angleto/phycommander/docs/INDEX.md

# PhyCMD Documentation Index

Complete guide to PhyCMD documentation.

## Quick Navigation

### 🚀 Getting Started
1. Start here: [README.md](../README.md)
2. Quick setup: [QUICK_REFERENCE.md](getting-started/QUICK_REFERENCE.md)
3. Full user guide: [USER_MANUAL.md](user-guide/USER_MANUAL.md)

### 📖 By Role

#### End Users
- **Start**: [USER_MANUAL.md](user-guide/USER_MANUAL.md)
- **Quick Reference**: [QUICK_REFERENCE.md](getting-started/QUICK_REFERENCE.md)
- **Setup**: [SETUP.md](getting-started/SETUP.md)

#### Developers
- **API Reference**: [API_REFERENCE.md](technical/API_REFERENCE.md)
- **Architecture**: [ARCHITECTURE.md](technical/ARCHITECTURE.md)
- **Protocol**: [PROTOCOL.md](technical/PROTOCOL.md)
- **Building**: [BUILDING.md](getting-started/BUILDING.md)

#### DevOps/System Administrators
- **Deployment**: [DEPLOYMENT.md](deployment/DEPLOYMENT.md)
- **Configuration**: [CONFIGURATION.md](user-guide/CONFIGURATION.md)
- **Performance**: [PERFORMANCE.md](technical/PERFORMANCE.md)
- **Real-Time OS Setup**: [REALTIME_OS_CONFIG.md](deployment/REALTIME_OS_CONFIG.md)

#### Hardware/Firmware Engineers
- **Firmware Upload**: [FIRMWARE_UPLOAD.md](firmware/FIRMWARE_UPLOAD.md)
- **Firmware Updates**: [FIRMWARE_UPDATES.md](firmware/FIRMWARE_UPDATES.md)
- **Wire Protocol**: [firmware/PROTOCOL.md](firmware/PROTOCOL.md) — byte-level spec, v1 + v2 reactive + v3 PID
- **Function Generator User Guide**: [user-guide/FUNCTION_GENERATOR.md](user-guide/FUNCTION_GENERATOR.md) — shapes, LUT, threshold, pulse, PID with examples
- **Device Pinout** (front + rear panel): [DEVICE_PINOUT.md](technical/DEVICE_PINOUT.md)
- **I/O Backplane PCB (Arduino Due shield)** — **design sketch, not fabricated**: [PCB_BACKPLANE_PINOUT.md](technical/PCB_BACKPLANE_PINOUT.md) · see README → Contributions wanted
- **Companion board** (Arduino Due shield + panel): [../companion_board/](../companion_board/)
  - PCB CAD project (KiCad 8 skeleton, **unfabricated**): [../companion_board/pcb/README.md](../companion_board/pcb/README.md)
  - Panel sketches (SVG masters; front+rear are realised on the reference build, PCB backplane layers are the not-yet-built companion shield): [../companion_board/panel_sketch/](../companion_board/panel_sketch/)

---

## Documentation by Category

### Core Documentation

| Document | Description | Length |
|---|---|---|
| [README.md](../README.md) | Main entry point and overview | 10 pages |
| [USER_MANUAL.md](user-guide/USER_MANUAL.md) | Complete user guide | 60 pages |
| [QUICK_REFERENCE.md](getting-started/QUICK_REFERENCE.md) | One-page cheat sheet | 3 pages |
| [API_REFERENCE.md](technical/API_REFERENCE.md) | Complete API documentation | 40 pages |

### Setup & Configuration

| Document | Description | Length |
|---|---|---|
| [SETUP.md](getting-started/SETUP.md) | Initial setup and installation | 15 pages |
| [BUILDING.md](getting-started/BUILDING.md) | Build instructions | 20 pages |
| [CONFIGURATION.md](user-guide/CONFIGURATION.md) | Configuration guide | 30 pages |
| [DEPLOYMENT.md](deployment/DEPLOYMENT.md) | Production deployment | 35 pages |
| [REALTIME_OS_CONFIG.md](deployment/REALTIME_OS_CONFIG.md) | Real-time Linux OS configuration | 45 pages |

### Technical Reference

| Document | Description | Length |
|---|---|---|
| [ARCHITECTURE.md](technical/ARCHITECTURE.md) | System design and architecture | 25 pages |
| [PROTOCOL.md](technical/PROTOCOL.md) | PhyCMD-64 protocol specification | 20 pages |
| [PERFORMANCE.md](technical/PERFORMANCE.md) | Performance benchmarks and tuning | 15 pages |
| [DEVICE_PINOUT.md](technical/DEVICE_PINOUT.md) | Front + rear panel pinout reference (all connectors) | 12 pages |
| [PCB_BACKPLANE_PINOUT.md](technical/PCB_BACKPLANE_PINOUT.md) | I/O distribution PCB pinout, BOM, routing | 18 pages |
| [FIRMWARE_UPLOAD.md](firmware/FIRMWARE_UPLOAD.md) | Firmware upload guide (BOSSA) | 15 pages |
| [FIRMWARE_UPDATES.md](firmware/FIRMWARE_UPDATES.md) | Required firmware changes | 10 pages |

**Total**: ~200+ pages of documentation

---

## Documentation by Task

### Installation & Setup

1. [SETUP.md](getting-started/SETUP.md) - Initial setup
2. [BUILDING.md](getting-started/BUILDING.md) - Build from source
3. [FIRMWARE_UPLOAD.md](firmware/FIRMWARE_UPLOAD.md) - Upload firmware
4. [REALTIME_OS_CONFIG.md](deployment/REALTIME_OS_CONFIG.md) - Configure RT OS (optional)
5. [DEPLOYMENT.md](deployment/DEPLOYMENT.md) - Production deployment

### Configuration

1. [CONFIGURATION.md](user-guide/CONFIGURATION.md) - Complete configuration reference
2. [QUICK_REFERENCE.md](getting-started/QUICK_REFERENCE.md) - Quick config examples
3. [DEPLOYMENT.md](deployment/DEPLOYMENT.md) - Production config

### Using PhyServer

1. [USER_MANUAL.md](user-guide/USER_MANUAL.md) - Complete usage guide
2. [QUICK_REFERENCE.md](getting-started/QUICK_REFERENCE.md) - Common operations
3. [API_REFERENCE.md](technical/API_REFERENCE.md) - API details

### Development

1. [API_REFERENCE.md](technical/API_REFERENCE.md) - API reference
2. [ARCHITECTURE.md](technical/ARCHITECTURE.md) - System design
3. [PROTOCOL.md](technical/PROTOCOL.md) - Protocol specification
4. [BUILDING.md](getting-started/BUILDING.md) - Build instructions

### Performance Tuning

1. [REALTIME_OS_CONFIG.md](deployment/REALTIME_OS_CONFIG.md) - Real-time OS setup
2. [PERFORMANCE.md](technical/PERFORMANCE.md) - Benchmarks and tuning
3. [CONFIGURATION.md](user-guide/CONFIGURATION.md) - RT configuration
4. [DEPLOYMENT.md](deployment/DEPLOYMENT.md) - Production optimization
5. [USER_MANUAL.md](user-guide/USER_MANUAL.md) - Real-time operation section

### Troubleshooting

1. [USER_MANUAL.md](user-guide/USER_MANUAL.md) - Troubleshooting section
2. [QUICK_REFERENCE.md](getting-started/QUICK_REFERENCE.md) - Quick fixes
3. [DEPLOYMENT.md](deployment/DEPLOYMENT.md) - Production troubleshooting
4. [SETUP.md](getting-started/SETUP.md) - Setup issues

---

## Documentation Features

### Code Examples

All documentation includes working code examples in:
- **Bash/cURL**: Command-line operations
- **Python**: REST API and automation
- **JavaScript**: Web interface and WebSocket
- **Rust**: IPC and native integration

### Practical Scenarios

- Development setup
- Production deployment
- High-performance configuration
- Multi-instance deployment
- Remote access setup
- Security hardening

### Complete Coverage

- ✅ Installation procedures
- ✅ Configuration options
- ✅ API endpoints
- ✅ Command-line tools
- ✅ Web interface
- ✅ IPC interface
- ✅ Troubleshooting
- ✅ Performance tuning
- ✅ Security
- ✅ Monitoring
- ✅ Backup/recovery

---

## Search Guide

### By Keyword

**Transport/Communication**:
- USB Bulk transport → [PERFORMANCE.md](technical/PERFORMANCE.md), [USER_MANUAL.md](user-guide/USER_MANUAL.md)
- Serial transport → [CONFIGURATION.md](user-guide/CONFIGURATION.md), [USER_MANUAL.md](user-guide/USER_MANUAL.md)
- Protocol → [PROTOCOL.md](technical/PROTOCOL.md), [ARCHITECTURE.md](technical/ARCHITECTURE.md)

**APIs**:
- REST API → [API_REFERENCE.md](technical/API_REFERENCE.md), [USER_MANUAL.md](user-guide/USER_MANUAL.md)
- WebSocket → [API_REFERENCE.md](technical/API_REFERENCE.md)
- IPC → [API_REFERENCE.md](technical/API_REFERENCE.md), [USER_MANUAL.md](user-guide/USER_MANUAL.md)

**Configuration**:
- TOML config → [CONFIGURATION.md](user-guide/CONFIGURATION.md)
- Command-line → [QUICK_REFERENCE.md](getting-started/QUICK_REFERENCE.md), [CONFIGURATION.md](user-guide/CONFIGURATION.md)
- Real-time → [REALTIME_OS_CONFIG.md](deployment/REALTIME_OS_CONFIG.md), [CONFIGURATION.md](user-guide/CONFIGURATION.md), [USER_MANUAL.md](user-guide/USER_MANUAL.md)
- RT kernel → [REALTIME_OS_CONFIG.md](deployment/REALTIME_OS_CONFIG.md)

**Deployment**:
- Systemd → [DEPLOYMENT.md](deployment/DEPLOYMENT.md)
- Security → [DEPLOYMENT.md](deployment/DEPLOYMENT.md)
- Monitoring → [DEPLOYMENT.md](deployment/DEPLOYMENT.md)

**Hardware**:
- Arduino Due → [README.md](../README.md), [FIRMWARE_UPLOAD.md](firmware/FIRMWARE_UPLOAD.md)
- Pin mapping → [USER_MANUAL.md](user-guide/USER_MANUAL.md), [PROTOCOL.md](technical/PROTOCOL.md), [DEVICE_PINOUT.md](technical/DEVICE_PINOUT.md)
- Front / rear panel connectors → [DEVICE_PINOUT.md](technical/DEVICE_PINOUT.md)
- I/O distribution PCB → [PCB_BACKPLANE_PINOUT.md](technical/PCB_BACKPLANE_PINOUT.md)
- SWD/JTAG debug port → [DEVICE_PINOUT.md](technical/DEVICE_PINOUT.md) §2.3
- CAN bus → [DEVICE_PINOUT.md](technical/DEVICE_PINOUT.md) §2.4
- Firmware → [FIRMWARE_UPLOAD.md](firmware/FIRMWARE_UPLOAD.md), [FIRMWARE_UPDATES.md](firmware/FIRMWARE_UPDATES.md)

---

## Documentation Structure

```
PhyCMD/
│
├── README.md                          # Start here
├── CONTRIBUTING.md                    # Contribution guidelines
├── CHANGELOG.md                       # Version history
├── LICENSE                            # AGPL-3.0 (server) + GPL-3.0 (firmware) + CERN-OHL-S v2 (hardware) + CC-BY-SA 4.0 (docs)
├── TRADEMARKS.md                      # Policy on "PhyCommander" name + logo
│
└── docs/
    ├── INDEX.md                       # This file
    │
    ├── getting-started/
    │   ├── SETUP.md                   # Initial setup
    │   ├── BUILDING.md                # Build instructions
    │   └── QUICK_REFERENCE.md         # Quick reference
    │
    ├── user-guide/
    │   ├── USER_MANUAL.md             # Complete user guide
    │   └── CONFIGURATION.md           # Configuration reference
    │
    ├── technical/
    │   ├── ARCHITECTURE.md            # System architecture
    │   ├── PROTOCOL.md                # Protocol specification
    │   ├── API_REFERENCE.md           # API documentation
    │   └── PERFORMANCE.md             # Performance guide
    │
    ├── deployment/
    │   ├── DEPLOYMENT.md              # Production deployment
    │   ├── REALTIME_OS_CONFIG.md      # Real-time OS configuration
    │   └── REMOTE_ACCESS.md           # Remote access guide
    │
    ├── firmware/
    │   ├── FIRMWARE_UPLOAD.md         # Firmware upload (BOSSA)
    │   └── FIRMWARE_UPDATES.md        # Firmware updates
    │
    └── reports/
        ├── PRODUCTION_READINESS_REPORT.md
        ├── PRODUCTION_READINESS_REPORT_FINAL.md
        └── PRODUCTION_READINESS_VERIFICATION.md
```

---

## Recommended Reading Order

### For New Users

1. [README.md](../README.md) - Overview
2. [SETUP.md](getting-started/SETUP.md) - Get it running
3. [USER_MANUAL.md](user-guide/USER_MANUAL.md) - Learn to use it
4. [QUICK_REFERENCE.md](getting-started/QUICK_REFERENCE.md) - Keep handy

### For Developers

1. [README.md](../README.md) - Overview
2. [ARCHITECTURE.md](technical/ARCHITECTURE.md) - Understand design
3. [PROTOCOL.md](technical/PROTOCOL.md) - Understand protocol
4. [API_REFERENCE.md](technical/API_REFERENCE.md) - Use APIs
5. [BUILDING.md](getting-started/BUILDING.md) - Build from source

### For System Administrators

1. [README.md](../README.md) - Overview
2. [REALTIME_OS_CONFIG.md](deployment/REALTIME_OS_CONFIG.md) - Configure RT OS
3. [DEPLOYMENT.md](deployment/DEPLOYMENT.md) - Deploy to production
4. [CONFIGURATION.md](user-guide/CONFIGURATION.md) - Configure properly
5. [PERFORMANCE.md](technical/PERFORMANCE.md) - Optimize performance

### For Integration Engineers

1. [README.md](../README.md) - Overview
2. [API_REFERENCE.md](technical/API_REFERENCE.md) - APIs
3. [PROTOCOL.md](technical/PROTOCOL.md) - Protocol
4. [ARCHITECTURE.md](technical/ARCHITECTURE.md) - Architecture

---

## Version Information

All documentation is for **PhyCMD v2.0.0**

Last updated: **2026-04-22**

---

## Contributing

When updating documentation:

1. **Keep consistent style** across all docs
2. **Include code examples** for all features
3. **Test all examples** before committing
4. **Update this index** when adding new docs
5. **Cross-reference** related documents

---

## External Resources

- **GitHub Repository**: https://github.com/angleto/phycommander
- **Issue Tracker**: https://github.com/angleto/phycommander/issues
- **Arduino Due**: https://www.arduino.cc/en/Guide/ArduinoDue
- **BOSSA**: https://www.shumatech.com/web/products/bossa
- **Rust**: https://www.rust-lang.org/

---

**For questions or feedback, please open an issue on GitHub.**
