angleto/phycommander/docs/reports/PRODUCTION_READINESS_REPORT.md

# PhyCMD Production Readiness Report

> **Archival document.** Captures the v1.0.0 production-readiness
> assessment at its release date. Left in the repo as historical
> record; for current production readiness of v2.0.0+ see the
> latest report in this directory.

**Date**: 2025-11-22
**Version**: 1.0.0 (historical)
**Reviewer**: Production Readiness Assessment
**Status**: ✅ **READY FOR PRODUCTION** (with recommendations)

---

## Executive Summary

PhyCMD is a **comprehensive, well-architected real-time hardware control system** that demonstrates professional-grade development practices. The project is **production-ready** with some recommended enhancements.

### Overall Assessment: **8.5/10**

**Key Strengths**:
- ✅ Excellent documentation (200+ pages covering all aspects)
- ✅ Clean, well-structured Rust codebase
- ✅ Comprehensive testing strategy with unit and integration tests
- ✅ Modular architecture with clear separation of concerns
- ✅ Production-grade error handling using Result types
- ✅ Complete deployment guide with systemd integration
- ✅ Security considerations documented
- ✅ Performance benchmarking completed

**Areas for Enhancement**:
- ⚠️ No CI/CD pipeline configured
- ⚠️ No LICENSE file in repository
- ⚠️ Firmware needs protocol updates (documented, not critical)
- ⚠️ Web interface lacks authentication (documented limitation)
- ℹ️ Test environment dependency on libudev (expected)

---

## Detailed Assessment

### 1. Code Quality: **9/10** ✅ EXCELLENT

**Strengths**:
- Modern Rust best practices (edition 2021)
- Proper use of type system (Result, Option)
- No unsafe code except necessary low-level operations (protocol serialization, IPC)
- Clean module structure with clear responsibilities
- Comprehensive error types with thiserror
- No TODO/FIXME/HACK markers in production code
- Code is well-commented where needed

**Metrics**:
- **Source Files**: 23 Rust files
- **Module Organization**: Clear hierarchy (protocol, transport, web, ipc, rt, telemetry)
- **Error Handling**: Comprehensive with anyhow::Result and custom error types
- **Code Style**: Consistent, follows Rust conventions

**Recommendations**:
1. Add `rustfmt.toml` and `clippy.toml` for consistent formatting
2. Consider adding more inline documentation for public APIs
3. Add pre-commit hooks for formatting/linting

---

### 2. Documentation: **10/10** ✅ EXCEPTIONAL

**Strengths**:
- **Comprehensive**: 200+ pages across 15 documents
- **Well-organized**: Clear index with role-based navigation
- **Practical**: Includes working code examples in multiple languages
- **Complete coverage**: Setup, configuration, deployment, API, architecture
- **Production-focused**: Deployment, monitoring, backup/recovery guides

**Documentation Files**:
```
Core Documentation:
- README.md (12KB) - Excellent overview
- USER_MANUAL.md - Complete user guide
- QUICK_REFERENCE.md - Quick command reference
- API_REFERENCE.md - Complete API documentation

Setup & Configuration:
- SETUP.md - Initial setup
- BUILDING.md - Build instructions
- CONFIGURATION.md (14KB) - Comprehensive config guide
- DEPLOYMENT.md (15KB) - Production deployment
- REALTIME_OS_CONFIG.md (26KB) - RT Linux configuration

Technical Reference:
- ARCHITECTURE.md (12KB) - System design
- PROTOCOL.md (12KB) - Protocol specification
- PERFORMANCE.md (9KB) - Benchmarks
- FIRMWARE_UPLOAD.md (10KB) - Firmware guide
- FIRMWARE_UPDATES.md (7KB) - Required updates
- REMOTE_ACCESS.md (14KB) - Remote access guide
```

**Recommendations**:
1. Add `CHANGELOG.md` for tracking version changes
2. Add `CONTRIBUTING.md` for contributors
3. Consider adding API documentation comments (rustdoc)

---

### 3. Testing: **7.5/10** ✅ GOOD

**Strengths**:
- Unit tests in all core modules
- Integration tests for protocol roundtrip
- Comprehensive protocol codec tests (15+ test cases)
- Configuration serialization tests
- CRC validation tests
- Error detection tests

**Test Coverage**:
```
Protocol Module:
✅ encode_command
✅ decode_status
✅ CRC validation
✅ Header validation
✅ Error detection
✅ Roundtrip encoding/decoding
✅ DAC clamping
✅ Invalid inputs

Configuration Module:
✅ Serialization/deserialization
✅ File I/O
✅ Default values
✅ Invalid input handling

IPC Module:
✅ Shared memory structure
✅ Basic validation
⚠️ Integration tests commented out (requires system resources)
```

**Test Files**:
- `physerver/tests/integration_test.rs` (171 lines)
- Unit tests embedded in modules
- Example client for manual testing

**Gaps**:
- No CI/CD for automated testing
- IPC integration tests disabled (understandable limitation)
- Web module lacks dedicated tests
- No load/stress tests documented

**Recommendations**:
1. **Add GitHub Actions CI/CD** for automated testing
2. Add web API integration tests using reqwest
3. Add load testing documentation/scripts
4. Consider adding property-based tests (proptest)
5. Add test coverage reporting (tarpaulin)

---

### 4. Architecture: **9/10** ✅ EXCELLENT

**Strengths**:
- Clean separation of concerns
- Modular transport layer (USB/Serial abstraction)
- Well-defined protocol boundaries
- Proper use of async/await with Tokio
- Smart use of shared memory for low-latency IPC
- WebSocket streaming for real-time updates

**Architecture Highlights**:
```
physerver/src/
├── lib.rs              # Public API exports
├── main.rs             # Application entry point (305 lines)
├── config.rs           # Configuration management (384 lines)
├── protocol/           # Protocol layer
│   ├── mod.rs          # Protocol constants and types
│   ├── types.rs        # Data structures
│   ├── codec.rs        # Encoding/decoding (264 lines)
│   └── crc.rs          # CRC-16 implementation
├── transport/          # Transport abstraction
│   ├── mod.rs          # Transport trait
│   ├── serial.rs       # Serial implementation
│   ├── usb.rs          # USB bulk implementation
│   └── traits.rs       # Transport interface
├── web/                # Web server (REST + WebSocket)
│   └── mod.rs          # Axum-based server (217 lines)
├── ipc/                # Shared memory IPC
│   └── mod.rs          # Lock-free IPC (276 lines)
├── rt/                 # Real-time optimizations
│   └── mod.rs          # RT scheduling, memory locking
└── telemetry/          # Logging
    └── mod.rs          # Tracing configuration
```

**Design Patterns**:
- ✅ Trait-based abstraction (Transport)
- ✅ Builder pattern (ShmemConf)
- ✅ Type-safe protocol with serde
- ✅ Lock-free IPC using atomics
- ✅ Broadcast channels for pub/sub

**Recommendations**:
1. Consider adding metrics/telemetry export (Prometheus)
2. Add health check endpoint
3. Consider adding graceful shutdown handling

---

### 5. Security: **7/10** ⚠️ GOOD (with caveats)

**Strengths**:
- Memory-safe Rust (no buffer overflows)
- CRC validation prevents data corruption
- Systemd hardening documented
- Firewall configuration documented
- Reverse proxy HTTPS setup documented
- Udev rules for device permissions

**Security Features Documented**:
```
✅ UFW/firewalld configuration
✅ IP-based access restrictions
✅ Nginx reverse proxy with HTTPS
✅ Basic auth setup
✅ SSH tunneling guidance
✅ VPN setup recommendations
✅ Systemd security options:
   - NoNewPrivileges=true
   - ProtectSystem=strict
   - ProtectHome=true
```

**Security Gaps**:
- ⚠️ **No built-in authentication** on REST API/WebSocket
- ⚠️ Web server binds to 0.0.0.0 by default
- ⚠️ No rate limiting
- ⚠️ No TLS/HTTPS support in physerver itself
- ⚠️ No audit logging

**Current Mitigation**:
- Documentation clearly states to use reverse proxy
- Firewall configuration instructions provided
- Default config can be changed to 127.0.0.1

**Recommendations**:
1. **High Priority**: Add basic authentication option
2. Add rate limiting middleware
3. Add audit logging for commands
4. Consider adding API key support
5. Add TLS support (or make reverse proxy mandatory)
6. Document security best practices more prominently

---

### 6. Dependencies: **8/10** ✅ GOOD

**Dependency Management**:
- Well-chosen, mature dependencies
- Minimal dependency count (focused)
- Proper use of feature flags
- No deprecated dependencies

**Key Dependencies**:
```toml
# Core
tokio = "1.35"           # Async runtime
serde = "1.0"            # Serialization
anyhow = "1.0"           # Error handling
thiserror = "1.0"        # Error types

# Transport
serialport = "4.3"       # Serial communication
rusb = "0.9"             # USB (optional)

# Web
axum = "0.7"             # Web framework
tower-http = "0.5"       # Middleware
tokio-tungstenite = "0.21" # WebSocket

# IPC
shared_memory = "0.12"   # Shared memory

# Real-time
nix = "0.27"             # System calls
libc = "0.2"             # C bindings

# Config
toml = "0.8"             # TOML parsing
clap = "4.4"             # CLI parsing

# Logging
tracing = "0.1"          # Structured logging
tracing-subscriber = "0.3"
```

**Dependency Status**:
- ✅ All dependencies actively maintained
- ✅ No known critical vulnerabilities
- ⚠️ Some dependencies have newer versions available (non-breaking)

**Recommendations**:
1. Add `cargo-audit` to CI pipeline
2. Set up Dependabot for automated updates
3. Consider pinning versions in production
4. Add `cargo-deny` for license compliance

---

### 7. Configuration Management: **9/10** ✅ EXCELLENT

**Strengths**:
- TOML-based configuration
- Command-line overrides
- Environment variable support (RUST_LOG)
- Comprehensive defaults
- Example configuration provided
- Well-documented options

**Configuration Features**:
```toml
[transport]
type = "usb" | "serial"
auto_detect = true
update_rate = 5000
serial_port = "/dev/ttyACM0"
baud_rate = 921600

[web]
enabled = true
port = 8080
bind_address = "0.0.0.0"

[realtime]
enabled = false
priority = 80
cpu_affinity = false
cpu_core = 2

[ipc]
enabled = true
shm_name = "phycmd_state"
```

**Validation**:
- ✅ Config validation on startup
- ✅ Helpful error messages
- ✅ Safe defaults
- ✅ Multiple configuration sources

**Recommendations**:
1. Add config validation subcommand
2. Add config generation tool
3. Consider JSON Schema for validation

---

### 8. Deployment: **9/10** ✅ EXCELLENT

**Strengths**:
- Complete systemd service file
- Udev rules for device permissions
- Multiple deployment scenarios documented
- Backup/recovery procedures
- Upgrade procedures with rollback
- Monitoring setup (Prometheus example)

**Deployment Documentation**:
```
✅ System requirements (min and recommended)
✅ Installation steps
✅ Systemd service setup
✅ Permissions configuration
✅ Firewall configuration
✅ Reverse proxy (Nginx) setup
✅ Monitoring setup
✅ Log rotation
✅ Backup procedures
✅ Upgrade procedures
✅ Troubleshooting guide
```

**Production Features**:
- Automatic restart on failure
- Log rotation configured
- Resource limits documented
- Health monitoring examples
- Alert setup examples

**Recommendations**:
1. Add Docker/container deployment option
2. Add Kubernetes manifests (if applicable)
3. Create deployment scripts
4. Add smoke tests for deployment validation

---

### 9. Performance: **9/10** ✅ EXCELLENT

**Benchmarks Documented**:
```
USB Bulk Transport:
- Max rate: 10 kHz ✅
- Avg latency: 120 µs ✅
- Jitter: ±7 µs ✅
- Throughput: 8 Mbps ✅

Serial Transport:
- Max rate: 1 kHz ✅
- Avg latency: 750 µs ✅
- Jitter: ±35 µs ✅
- Throughput: 900 kbps ✅
```

**Optimizations**:
- ✅ Release profile optimized (LTO, strip)
- ✅ Real-time scheduling support
- ✅ CPU affinity support
- ✅ Memory locking
- ✅ Zero-copy IPC using atomics

**Recommendations**:
1. Add continuous performance monitoring
2. Document regression testing procedures
3. Add performance CI checks

---

### 10. Error Handling & Robustness: **8.5/10** ✅ EXCELLENT

**Strengths**:
- Comprehensive error types (ProtocolError)
- Proper Result propagation
- CRC validation
- Graceful degradation
- Error logging
- Watchdog support (firmware)

**Error Handling Examples**:
```rust
pub enum ProtocolError {
    InvalidHeader { expected: u16, got: u16 },
    CrcMismatch { expected: u16, got: u16 },
    InvalidLength { expected: usize, got: usize },
    SequenceMismatch { expected: u8, got: u8 },
    InvalidField { field: String, value: u16 },
}
```

**Robustness Features**:
- ✅ Communication continues on errors
- ✅ Sequence number validation
- ✅ Error counters
- ✅ Warnings for abnormal conditions
- ✅ Automatic retry on communication errors

**Recommendations**:
1. Add circuit breaker pattern for device failures
2. Add exponential backoff for retries
3. Document error recovery procedures

---

## Critical Issues: **NONE** ✅

No critical issues found that would prevent production deployment.

---

## High Priority Recommendations

### 1. Add CI/CD Pipeline ⚠️ **HIGH PRIORITY**

**Impact**: Automation, quality assurance
**Effort**: 2-4 hours

**Recommended setup**:
```yaml
# .github/workflows/ci.yml
name: CI

on: [push, pull_request]

jobs:
  test:
    runs-on: ubuntu-latest
    steps:
      - uses: actions/checkout@v2
      - uses: actions-rs/toolchain@v1
        with:
          toolchain: stable
      - name: Install dependencies
        run: sudo apt-get install -y libudev-dev pkg-config
      - name: Build
        run: cd physerver && cargo build --verbose
      - name: Run tests
        run: cd physerver && cargo test --verbose
      - name: Check formatting
        run: cd physerver && cargo fmt -- --check
      - name: Clippy
        run: cd physerver && cargo clippy -- -D warnings
```

---

### 2. Add LICENSE File ⚠️ **HIGH PRIORITY**

**Impact**: Legal clarity
**Effort**: 5 minutes

README indicates MIT license, but no LICENSE file present.

**Action**: Add MIT LICENSE file to repository root.

---

### 3. Add Basic Authentication ⚠️ **MEDIUM PRIORITY**

**Impact**: Security
**Effort**: 4-8 hours

**Recommended approach**:
- Add optional API key support
- Add token-based authentication
- Make configurable (disabled by default for backward compatibility)

---

### 4. Complete Firmware Updates 📋 **PLANNED**

**Impact**: Feature completeness
**Effort**: 14-21 hours (documented)

The firmware updates are well-documented in `FIRMWARE_UPDATES.md`. This is a planned enhancement, not a blocker.

**Current status**:
- ✅ Basic protocol working
- ✅ Documentation complete
- ⏳ Enhanced features pending

---

## Medium Priority Recommendations

1. **Add CHANGELOG.md** - Track version changes
2. **Add CONTRIBUTING.md** - Guide for contributors
3. **Add cargo-audit to CI** - Dependency vulnerability scanning
4. **Add integration tests for web API** - Better test coverage
5. **Add health check endpoint** - /health or /api/health
6. **Add metrics endpoint** - Prometheus-compatible metrics
7. **Add Docker support** - Container deployment option

---

## Low Priority Recommendations

1. Add rustdoc comments for public APIs
2. Add benchmarking suite (criterion)
3. Add property-based tests (proptest)
4. Add code coverage reporting
5. Consider adding GraphQL API (alternative to REST)
6. Add web dashboard screenshots to README
7. Create video tutorial/demo

---

## Production Deployment Checklist

### Pre-Deployment

- [ ] Build release binary: `cargo build --release`
- [ ] Run all tests: `cargo test --all`
- [ ] Review configuration file
- [ ] Set up system user and permissions
- [ ] Install udev rules
- [ ] Configure firewall
- [ ] Set up systemd service
- [ ] Configure log rotation
- [ ] Set up monitoring
- [ ] Document hardware setup
- [ ] Create backup procedure
- [ ] Test backup restoration

### Deployment

- [ ] Install physerver binary
- [ ] Install configuration file
- [ ] Upload firmware to Arduino Due
- [ ] Start systemd service
- [ ] Verify device detection
- [ ] Test REST API
- [ ] Test WebSocket
- [ ] Test IPC (if enabled)
- [ ] Check logs for errors
- [ ] Verify performance metrics
- [ ] Run smoke tests

### Post-Deployment

- [ ] Monitor service health (24 hours)
- [ ] Check error rates
- [ ] Verify performance
- [ ] Test failover/restart
- [ ] Document any issues
- [ ] Update runbook if needed

---

## Comparison to Industry Standards

| Criterion | PhyCMD | Industry Standard | Status |
|---|---|---|---|
| Documentation | ✅ 200+ pages | Required | **Exceeds** |
| Testing | ✅ Unit + Integration | Required | **Meets** |
| Error Handling | ✅ Comprehensive | Required | **Exceeds** |
| Logging | ✅ Structured (tracing) | Required | **Meets** |
| Configuration | ✅ TOML + CLI | Required | **Meets** |
| Deployment | ✅ Systemd + docs | Required | **Exceeds** |
| Security | ⚠️ Reverse proxy auth | Built-in preferred | **Adequate** |
| CI/CD | ❌ None | Required | **Missing** |
| Monitoring | ✅ Documented | Required | **Meets** |
| Performance | ✅ Benchmarked | Required | **Exceeds** |

---

## Risk Assessment

### Low Risk ✅
- Code quality issues
- Performance issues
- Deployment failures
- Configuration errors
- Hardware compatibility

### Medium Risk ⚠️
- Security (mitigated by reverse proxy)
- Lack of automated testing pipeline
- Dependency vulnerabilities (no audit)

### High Risk ❌
- **None identified**

---

## Conclusion

**PhyCMD is PRODUCTION-READY** with the following caveats:

1. **Must configure reverse proxy** for authentication (documented)
2. **Recommended to add CI/CD** before team scaling
3. **Add LICENSE file** before public release

The project demonstrates **excellent engineering practices**:
- Comprehensive documentation
- Clean architecture
- Proper error handling
- Good test coverage
- Production deployment guide
- Performance benchmarking

**Overall Grade: A- (8.5/10)**

### Deployment Recommendation

✅ **APPROVED FOR PRODUCTION** in controlled environments (internal use, trusted networks)

⚠️ **RECOMMENDED ENHANCEMENTS** before public/untrusted deployment:
1. Add authentication
2. Set up CI/CD
3. Add security audit
4. Add LICENSE file

---

## Next Steps

### Immediate (Before First Production Deployment)
1. Add LICENSE file (MIT)
2. Configure firewall
3. Set up reverse proxy with auth
4. Deploy to production environment
5. Monitor for 48 hours

### Short Term (1-2 weeks)
1. Set up CI/CD pipeline
2. Add basic authentication
3. Add health check endpoint
4. Set up automated backups

### Medium Term (1-2 months)
1. Complete firmware updates
2. Add integration tests
3. Set up metrics/monitoring
4. Security audit

### Long Term (3-6 months)
1. Add advanced features
2. Performance optimizations
3. Extended documentation
4. Community building

---

**Report Generated**: 2025-11-22
**Reviewed By**: Production Readiness Assessment
**Recommendation**: ✅ **APPROVED FOR PRODUCTION**

---
