angleto/phycommander/docs/deployment/DEPLOYMENT.md

# PhyCMD Deployment Guide

Complete guide for deploying PhyServer in production environments.

## Table of Contents

1. [Deployment Overview](#deployment-overview)
2. [System Requirements](#system-requirements)
3. [Installation](#installation)
4. [Systemd Service](#systemd-service)
5. [Security](#security)
6. [Networking](#networking)
7. [Monitoring](#monitoring)
8. [Backup and Recovery](#backup-and-recovery)
9. [Upgrades](#upgrades)
10. [Troubleshooting](#troubleshooting)

---

## Deployment Overview

### Deployment Checklist

- [ ] Hardware connected and tested
- [ ] Operating system configured
- [ ] Dependencies installed
- [ ] PhyServer built with release profile
- [ ] Configuration file created
- [ ] System permissions configured
- [ ] Real-time optimizations applied (see [REALTIME_OS_CONFIG.md](REALTIME_OS_CONFIG.md))
- [ ] Systemd service configured
- [ ] Firewall configured
- [ ] Monitoring configured
- [ ] Backup procedure established

### Deployment Scenarios

1. **Edge Device**: Standalone embedded system
2. **Laboratory Server**: Multi-user access via web interface
3. **Industrial Control**: High-reliability, real-time operation
4. **Test Automation**: Integrated with CI/CD systems

---

## System Requirements

### Minimum Requirements

**Hardware**:
- CPU: Intel Atom or equivalent (x86-64)
- RAM: 512 MB
- Storage: 100 MB for binaries + logs
- USB 2.0 port
- Arduino Due (ATSAM3X8E)

**Operating System**:
- Linux kernel 4.4+ (Ubuntu 20.04+ recommended)
- Real-time kernel (optional, for <10µs jitter)

**Network** (if using web interface):
- Ethernet or WiFi connectivity
- Static IP recommended for production

### Recommended Requirements

**For High Performance** (>5 kHz):
- CPU: Multi-core processor (e.g., Intel Core i3+)
- RAM: 1 GB+
- RT-preempt kernel or PREEMPT_RT patch
- CPU core isolation
- Fast USB 2.0/3.0 controller

See [REALTIME_OS_CONFIG.md](REALTIME_OS_CONFIG.md) for complete real-time OS configuration instructions

---

## Installation

### 1. Install Dependencies

**Ubuntu/Debian**:
```bash
sudo apt-get update
sudo apt-get install -y \
    build-essential \
    pkg-config \
    libudev-dev \
    curl \
    git
```

**Fedora/RHEL**:
```bash
sudo dnf install -y \
    gcc \
    pkg-config \
    libudev-devel \
    curl \
    git
```

### 2. Install Rust

```bash
curl --proto '=https' --tlsv1.2 -sSf https://sh.rustup.rs | sh
source $HOME/.cargo/env
rustc --version  # Verify installation
```

### 3. Build PhyServer

```bash
# Clone repository
git clone https://github.com/angleto/phycommander.git
cd phycommander/physerver

# Build release version
cargo build --release

# Verify binary
./target/release/physerver --version
```

### 4. Install System-Wide

```bash
# Copy binary
sudo cp target/release/physerver /usr/local/bin/

# Create config directory
sudo mkdir -p /etc/physerver

# Copy configuration
sudo cp config.example.toml /etc/physerver/config.toml

# Edit configuration
sudo nano /etc/physerver/config.toml

# Verify
physerver --version
```

### 5. Configure Permissions

```bash
# Add user to dialout group
sudo usermod -a -G dialout $USER

# Grant real-time capabilities
sudo setcap cap_sys_nice,cap_ipc_lock,cap_sys_admin=eip /usr/local/bin/physerver

# Verify
getcap /usr/local/bin/physerver
```

### 6. Create Udev Rules

Create `/etc/udev/rules.d/99-arduino-due.rules`:

```bash
# Arduino Due (Programming Port)
SUBSYSTEM=="usb", ATTR{idVendor}=="2341", ATTR{idProduct}=="003e", MODE="0666", GROUP="dialout"

# Arduino Due (Native USB Port)
SUBSYSTEM=="usb", ATTR{idVendor}=="2341", ATTR{idProduct}=="003d", MODE="0666", GROUP="dialout"
```

Reload rules:
```bash
sudo udevadm control --reload-rules
sudo udevadm trigger
```

---

## Systemd Service

### Service File

Create `/etc/systemd/system/physerver.service`:

```ini
[Unit]
Description=PhyServer - Physical Commander Server
Documentation=https://github.com/angleto/phycommander
After=network.target
Wants=network-online.target

[Service]
Type=simple
User=physerver
Group=dialout
ExecStart=/usr/local/bin/physerver --config /etc/physerver/config.toml
Restart=always
RestartSec=5
StartLimitBurst=5
StartLimitIntervalSec=60

# Environment
Environment="RUST_LOG=info"

# Working directory
WorkingDirectory=/var/lib/physerver

# Security
NoNewPrivileges=true
ProtectSystem=strict
ProtectHome=true
ReadWritePaths=/var/lib/physerver
ReadWritePaths=/var/log/physerver

# Real-time scheduling
LimitMEMLOCK=infinity
LimitNICE=-20

# Capabilities
AmbientCapabilities=CAP_SYS_NICE CAP_IPC_LOCK CAP_SYS_ADMIN

[Install]
WantedBy=multi-user.target
```

### Create User and Directories

```bash
# Create user
sudo useradd -r -s /bin/false physerver
sudo usermod -a -G dialout physerver

# Create directories
sudo mkdir -p /var/lib/physerver
sudo mkdir -p /var/log/physerver
sudo chown physerver:dialout /var/lib/physerver
sudo chown physerver:dialout /var/log/physerver
```

### Enable and Start Service

```bash
# Reload systemd
sudo systemctl daemon-reload

# Enable service (start on boot)
sudo systemctl enable physerver

# Start service
sudo systemctl start physerver

# Check status
sudo systemctl status physerver

# View logs
sudo journalctl -u physerver -f
```

### Service Management

```bash
# Start
sudo systemctl start physerver

# Stop
sudo systemctl stop physerver

# Restart
sudo systemctl restart physerver

# Status
sudo systemctl status physerver

# Logs (last 100 lines)
sudo journalctl -u physerver -n 100

# Follow logs
sudo journalctl -u physerver -f

# Logs since boot
sudo journalctl -u physerver -b
```

---

## Real-time tuning (reduce scheduler jitter tail)

On a host booted with `isolcpus=2,3 nohz_full=2,3 rcu_nocbs=2,3`
(typical for a PREEMPT_RT DAQ box), two extra steps lower the tail
of the jitter histogram exposed at `/api/rt_stats.jitter_histogram`:

1. **Pin the scheduler** to an isolated core via `config.toml`:

   ```toml
   [realtime]
   cpu_affinity = true
   cpu_core = 2
   ```

2. **Pin the USB host controller's IRQ** to the *other* isolated
   core so its completion work doesn't contend with the scheduler:

   ```bash
   sudo ./scripts/pin_usb_irq.sh        # auto-detects IRQ, pins to core 3
   sudo ./scripts/pin_usb_irq.sh 3 23   # or: pin specific IRQ
   ```

   Make it stick across reboots by dropping a systemd unit or an
   `@reboot` cron entry that re-runs the script. Alternatively add
   a rule to `/etc/tmpfiles.d/` that writes the desired affinity
   to `/proc/irq/<N>/smp_affinity_list`.

   If `irqbalance` is active it will periodically undo the pin —
   disable it on dedicated DAQ hosts:

   ```bash
   sudo systemctl disable --now irqbalance
   ```

Expected improvement: the bucket count for jitter > 1 ms typically
drops by an order of magnitude on the reference DN2800MT hardware.

---

## Security

### Firewall Configuration

**UFW (Ubuntu)**:
```bash
# Enable firewall
sudo ufw enable
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
