angleto/phycommander/(list of files, cad)

Other CAD files:
docs/hardware/FrontPanel_2014.dwg
