angleto/phycommander/CHANGELOG.md

# Changelog

All notable changes to PhyCMD will be documented in this file.

The format is based on [Keep a Changelog](https://keepachangelog.com/en/1.0.0/),
and this project adheres to [Semantic Versioning](https://semver.org/spec/v2.0.0.html).

## [Unreleased]

## [2.1.2] - 2026-06-11

Patch release: systemd readiness fix for iso-mode deployments. No
protocol or wire-format changes; all 2.1.x clients and firmware
interoperate.

### Fixed

- **physerver: `sd_notify(READY)` and the watchdog kicker now fire in
  iso mode too**. The systemd-integration block lived only in the
  bulk path of `main()`, so an iso-mode service running under the
  `Type=notify` unit (`deploy/systemd/physerver.service`) never
  reported readiness: systemd hit `TimeoutStartSec` and restart-looped
  the service every ~90 s even though the web server and iso transport
  were healthy. The block is now `notify_systemd_ready()`, called from
  both transport paths.

## [2.1.1] - 2026-04-30

Patch release: dashboard scope smoothness, firmware DAC-write fix,
SAM-BA detection robustness in the flash script, and licensing copy
clean-up. No protocol or wire-format changes; 2.1.0 clients talk to
2.1.1 firmware and vice versa.

### Added

- **Dashboard scope: WS adc_chunk stream**. New typed message on `/ws`
  (`{"type":"adc_chunk","data":{...}}`) ships micro-batches of the
  full 8 kHz ADC ring (~125 Hz tick, ~64 samples/chunk). The browser
  scope consumes the stream directly; HTTP polling on
  `/api/adc/capture` stays as a cold-start / WS-down fallback.
- **Dashboard scope: 150 ms playback buffer**. The renderer anchors
  the right edge to `performance.now() - 150 ms` so bursty arrival
  lands behind the visible window. Decouples 60 Hz canvas refresh
  from chunk cadence; cost is 150 ms of latency on the trace.
- **Dashboard scope: unified 8 kHz timeline**. The legacy 250 Hz
  scope buffer is gone. ADC, DIN, DOUT, and host-side DAC/PWM synth
  values now ride the same `scopeAdc` buffer, so non-synthesizable
  DAC shapes (manual / arbitrary / LUT) get 8 kHz time resolution.
- **Concept docs for follow-on applications** under
  `docs/applications/`: piezo Bode harvester, vision sorter, laser
  tracker.

### Changed

- **Dashboard rows labelled by Due silkscreen pin** for DAC, PWM,
  DOUT, and the on-chip function-generator block.
- **Firmware: WORD-mode buffer pack + HALF-mode manual DAC write**.
  Cleans up a pack-mode mismatch in the iso TX path so manual DAC
  values written via the streaming Command frame land at the pad
  on the next microframe instead of the one after.
- **`scripts/flash_firmware.sh`**: detect the SAM-BA CDC after the
  reset trigger, not before. The pre-trigger probe was racing the
  device disappearance window and occasionally locking onto the
  programming-port CDC instead, then failing once SAM-BA enumerated.
- **README**: clearer commercial-use paragraph, GitHub-only contact
  (no exposed mailto), explicit note that the AGPL/GPL/CERN-OHL-S
  copyleft licences already permit commercial distribution under
  their terms.

### Fixed

- CI: rustfmt nightly reflow on a docstring that the WS adc_chunk
  patch had wrapped at suboptimal points.

## [2.1.0] - 2026-04-26

Bench-cycle release: hardware layout aligned with the assembled v2.0
unit (12 ADC + 8 PWM + 16 DOUT + 16 DIN + 2 DAC), JTAG-free firmware
update path, and a long list of dashboard / firmware fixes flushed
out by the new HTTP-driven loopback test suite.

### Added

- **JTAG-free firmware update** (`VREQ_FW_ENTER_BOOTLOADER 0x40`).
  The running firmware can now drop the SAM3X into ROM SAM-BA on
  request: clears `GPNVM1` via EEFC `CGPB`, then writes
  `RSTC_CR = KEY | PROCRST | PERRST | EXTRST` for a full chip reset
  including the USB peripheral. Exposed as
  `POST /api/firmware/enter-bootloader` on physerver. The legacy
  1200-baud / ATmega16U2 trick remains as a fallback in
  `scripts/flash_firmware.sh` (new `--entry auto|fngen|1200baud`
  flag). End-to-end verified on the bench: api → SAM-BA → bossac →
  RSTC_CR → app, no J-Link required. See `docs/firmware/PROTOCOL.md`
  §2.6 and `docs/firmware/FIRMWARE_UPLOAD.md`.
- HTTP-driven bench loopback test suite
  (`physerver/tests/bench_loopback.rs`): DAC linearity, PWM duty
  endpoints + monotonic sweep, GPIO walking-ones / walking-zeros
  (auto-skip when no DOUT/DIN loopback wiring is present), ADC
  idle-stability with stuck-0x800 regression detector. Gated by
  `PHYCMD_BENCH=1`. 7/7 green on the v2.0 wiring.
- Full-rate ADC capture endpoint + browser scope feed
  (`/api/adc/capture` + dashboard scope panel).
- Reset button on D3 (PC28, 50 ms debounce → `RSTC_CR`).

### Changed

- **Wire protocol layout for v2.0 bench**: `StatusMessage.adc[8]` →
  `adc[12]`, `reserved[30]` → `reserved[22]`. CRC range bumped from
  24 to 32 bytes; firmware and host both use `offset_of!` /
  `CRC_OVER_STAT_BYTES` to track the wire layout. `Capabilities`
  now reports `num_pwm = 8`, `num_adc = 12`. `protocol_version`
  stays at 1.
- 8 PWM channels via mixed PWM peripheral + TC paths
  (D9/D8/D7/D6/D10/D11/D5/D2). PWM 4..7 use TC modules; D11/D10
  share TC2 channels by design.
- Default outputs OFF at boot: physerver stops fngen on every
  channel and zeros the streaming `Command` at iso transport
  startup, so the bench never comes up driving anything.
- Dashboard PWM slider / fngen mutual exclusion removed —
  last-action-wins now. Sliders no longer disable the function-row
  Stop button; setting a duty fires `pwmSliderResetTo(ch, 0)` on
  the corresponding fngen lane.
- Dashboard ADC scope panel + masonry layout, smoother poll loop
  covering all 12 ADC channels, sliders sync from `/api/command` at
  page load.
- `enter_bootloader()` host helper now treats `LIBUSB_ERROR_IO`,
  `LIBUSB_ERROR_NO_DEVICE`, and `LIBUSB_ERROR_TIMEOUT` all as
  success — empirically the kernel returns `IO (-1)` most often
  when the firmware resets mid-status-stage, not the timeout we
  initially mapped.

### Fixed

- Firmware ADC: only enable channels we actually sample. The
  earlier sparse `CHER` + PDC race could leave late slots reading
  a stale `0x800`, masquerading as silicon faults. Free-running
  ADC with direct CDR reads now drives the canonical AD0..AD11
  path.
- Firmware TC-PWM `match_reg` clamp away from 0 so duty=1.0 stays
  HIGH instead of glitching one cycle to LOW.
- Bench-loopback default wiring map for pwm2/pwm3 (was inverted).
- `bench_adc_idle_stability` no longer false-positives on floating
  DAC/PWM pins: drives DAC mid-scale and PWM duty=0 before
  measuring. Stuck-0x800 detection still fires unconditionally.
- CI rustfmt + `-D warnings` tripwires (unused imports, dead code,
  long lines).

## [2.0.0] - 2026-04-22

Clean re-baseline of the project: the previous `v1.x` history was
retired from the public remote alongside this release. The v1.x
branches and tags are no longer available on `origin`; anyone who
had already cloned them may keep using that code under the old
licence terms, but no new v1.x fixes will be published. This is the
first release of the copyleft era.

### Changed — licensing (BREAKING)

Full relicensing of the project with explicit copyleft protection
across every layer. The previous `MIT OR Apache-2.0` arrangement is
retired for the software components. Sole author, no prior external
contributions required relicensing consent.

- **Software** (Rust server, `phycmd-core`, `phycmd-rust`, `phycmd-py`,
  dashboard HTML/JS): **AGPL-3.0-or-later** — network-aware copyleft
  to prevent silent SaaS appropriation.
- **Firmware** (SAM3X8E C code), **deployment plumbing**, and
  **CLI scripts**: **GPL-3.0-or-later**.
- **Hardware designs** (KiCad project, panel SVGs, mechanical CAD):
  **CERN-OHL-S v2** (Strongly Reciprocal).
- **Prose documentation + photographs**: unchanged, **CC-BY-SA 4.0**.
- **Project name + logo**: now covered by an explicit trademark
  policy (`TRADEMARKS.md`). Forks that diverge from upstream must
  rename before distribution.
- Every source file gained an `SPDX-License-Identifier` header.
- `LICENSE-MIT` and `LICENSE-APACHE` removed; `LICENSE-AGPL-3.0`,
  `LICENSE-GPL-3.0`, and `LICENSE-CERN-OHL-S-2.0` added.
- Workspace and firmware version bumped to `2.0.0` across all
  manifests (`physerver`, `phycmd-core`, `phycmd-rust`, `phycmd-py`,
  `pyproject.toml`, firmware `USB_DEVICE_MAJOR_VERSION`).

### Changed — DAC reactive path (BREAKING)

The `reactive_dac_write` CPU-to-`DACC_CDR` direct write race was
structurally broken pre-2.0. Fixed by routing LUT / THRESHOLD / PID
output through a per-channel `reactive_value` field that the PDC
refill loop emits on every sample. Downstream firmware/drivers that
depended on the old (non-working) behaviour must retest.

### Added — host-side auto-reconnect

Iso transport now detects firmware watchdog resets: an I/O thread
session loop monitors `iso_in_pkts_ok` and, after 4 s of no progress,
tears down + re-opens the libusb device handle. Firmware now actually
enables the SAM3X WDT (2 s timeout, 500 ms SysTick kick) so a wedged
firmware reboots itself and the host re-establishes the stream with
no operator action.

### Added — API

- `CommandStaging::set_*_with_timeout(value, Duration)` for bounded
  waits on the staging buffer; new `StagingError::Timeout` variant.
- `CHAN_STATE_FLAG_RESERVED` exposed in the protocol and surfaced as
  `ChannelStateView.reserved` so clients can render non-backed
  channels (currently PWM 4..7 on Due) as unavailable.
- `/api/waveform/coexistence` REST endpoint + dashboard badge that
  warns when host-side `WaveformBank` and firmware on-chip generator
  overlap on the same DAC/PWM channel.
- `scripts/rt_benchmark.py` stdlib-only harness for RT-loop / iso
  metrics capture; `docs/technical/XHCI_NOTES.md` with the
  measurement protocol.
- IPC `IpcServer` / `IpcClient` now implement `Send + Sync`
  (documented safety argument); `read_command_with_seq` added.
  Shared memory is now actually populated on every status frame, and
  commands pushed by external clients via IPC reach staging. Fixes a
  silent regression from the iso-mode rework.
- Iso DMA buffers allocated via custom `AlignedBuffer` with 64 B
  cache-line alignment (required on non-coherent ARM hosts).
- libusb version logged at startup.

### Fixed

- `threshold_eval` hysteresis condition restored (`|| true` residue
  removed).
- `Capabilities.num_pwm` now matches `WAVE_NUM_PWM_ACTIVE` (4) instead
  of falsely advertising 8 BUILTIN-capable PWM channels.
- `refill_buffer` MANUAL fallback holds the last applied DAC value
  instead of snapping to mid-rail on a GENERATOR → MANUAL transition.
- Dead `ADC_Handler` + `update_adc_irq_needed` stub removed from
  firmware; ADC IRQ is now unambiguously off and reactive evaluation
  documented as SysTick-driven.
- `tests/selftest.rs` rewritten to use `physerver::protocol`
  (CRC-validated) instead of the stale pre-CRC raw layout.
- Obsolete `NUM_TX_SLOTS` comment updated from 16 to 64.

## [1.1.0] - 2026-04-14

_Removed from the public remote in 2.0.0; notes preserved for
archival purposes._

First public open-source release. Repo renamed from `phycmd` →
`phycommander`, default branch is now `v1.1`. Older branches deleted.

### Added — firmware (SAM3X8E)
- On-chip function generator: BUILTIN / ARBITRARY / LUT / THRESHOLD /
  PULSE_TRIG / PID per channel.
- MODE_PWM_DUTY on PWM0..PWM3 (PIOC21..24 → Due pins 9/8/7/6).
- `loop_time_us` populated via DWT cycle counter.
- `waveform_reactive_dout_mask()` so iso Command frames don't
  overwrite reactive-driven DOUTs.
- DOUT reactive shape echoed in `get_state` so the dashboard
  indicator turns green on Apply.
- Reactive ADC eval moved from ADC_Handler (≈60 kHz ENDRX) to the
  1 kHz SysTick — avoids the USB stack hang we hit when the per-ISR
  evaluation rate starved UOTGHS microframes.

### Added — host (Rust physerver)
- 8 kHz isochronous USB transport with per-packet `seq_num` and
  per-microframe round-trip latency tracking.
- URB-level jitter measurement against the 1 ms expected cadence.
- `IsoTransport::set_telemetry_detail()` toggle to pause the
  per-packet seq + latency tracking in the iso hot path.
- `POST /api/reset_telemetry` zeroes RT-stats counters + IsoStats
  + error baseline.
- `GET / POST /api/telemetry/detail` JSON endpoint.
- Dashboard-served logo (`/logo.svg`, `/logo-mark.svg`) with
  `Cache-Control: public, max-age=3600`.
- `Cache-Control: no-store` on the dashboard HTML to prevent
  browsers serving stale JS after a redeploy.

### Added — dashboard
- On-Chip Function Generator panel: 2 DAC + 4 PWM + 16 DOUT rows,
  per-row mode dropdown, parameter form with `userDirty` flag
  protecting in-progress edits from the 1 s state poll.
- 16-row DOUT strip with green/grey indicator + click-to-expand
  config + one-click stop.
- Oscilloscope: analytic canvas-pixel rendering for DAC sine /
  square / triangle / sawtooth and for on-chip PWM squares
  (bypasses the WebSocket 250 Hz throttle).
- Collapsible panels with persistent `localStorage` state.
- Φ> logo in the header + as the favicon.
- Reset Telemetry button in the RT Scheduler Stats panel.
- Click-to-toggle Seq badge in the status bar.
- Fixed-width measurement table columns with `tabular-nums` so
  values don't shift horizontally as digits change width.

### Added — release infrastructure
- Dual-licensed MIT OR Apache-2.0 (software) + CC-BY-SA 4.0
  (hardware designs, panel CAD, photos, long-form docs).
  Three canonical license files committed alongside the top-level
  LICENSE summary and a NOTICE file.
- `Φ>` logo (full mark + favicon variant) in `physerver/static/`.
- `CODE_OF_CONDUCT.md` (Contributor Covenant 2.1) and
  `SECURITY.md` (private report channel + 90-day disclosure).
- `docs/hardware/FrontPanel_2014.dwg` — original AutoCAD source
  for the steel front panel.
- 4 hardware photos + 4 dashboard screenshots in `docs/images/`.
- BOM section in README listing the reference Amazon IT chassis
  ASINs and the through-hole signal-conditioning parts.
- 2014 → 2026 history paragraph in the README.
- `xHCI vs EHCI` performance note in the BOM (xHCI gives extra
  headroom past the 8 kHz EHCI ceiling).

### Changed
- Cargo.toml `authors` → `Angelo Leto <angelo@leto.blue>`,
  `license` → `MIT OR Apache-2.0`.
- Default branch on the GitHub repo: `v1.0` → `v1.1`.
- Repo renamed: `angleto/phycmd` → `angleto/phycommander`.

### Fixed
- `update_adc_irq_needed()` was never called from `play_lut` /
  `play_threshold` / `stop` — reactive modes were armed but their
  evaluator never ran.
- `set_dig_out_value` was overwriting reactive DOUT writes at
  microframe rate. Now it skips the bits in
  `waveform_reactive_dout_mask()`.
- LUT default `output_mask` for a per-DOUT row was 0xFFFF — picking
  LUT on one DOUT drove all 16 pins. Now defaults to `1 << idx`.
- Fmt sweep across the workspace so the CI fmt gate passes.

## [1.0.0] - 2025-11-22

### Added
- Initial release
- Dual transport system (USB Bulk + USB CDC Serial)
- REST API server with Axum
- WebSocket streaming support
- Shared memory IPC for low-latency communication
- Real-time scheduling support
- Web dashboard interface
- Complete documentation suite (200+ pages)
- Example client implementations
- Systemd service configuration
- TOML-based configuration
- CRC-16 protocol validation
- Performance benchmarks

## [1.0.0] - 2025-11-22

### Added
- Initial release
- Dual transport system (USB Bulk + USB CDC Serial)
- REST API server with Axum
- WebSocket streaming support
- Shared memory IPC for low-latency communication
- Real-time scheduling support
- Web dashboard interface
- Complete documentation suite (200+ pages)
- Example client implementations
- Systemd service configuration
- TOML-based configuration
- CRC-16 protocol validation
- Performance benchmarks

### Features
- **Transport**:
  - USB Bulk transport (10 kHz, 120µs latency)
  - USB CDC Serial transport (1 kHz, 750µs latency)
  - Auto-detection with fallback
  - Modular transport abstraction

- **API**:
  - REST API for command/status
  - WebSocket for real-time streaming
  - Shared memory IPC
  - GPIO, ADC, DAC control

- **Real-Time**:
  - RT scheduler support (SCHED_FIFO)
  - Memory locking (mlockall)
  - CPU affinity
  - DMA latency control

- **Documentation**:
  - User manual
  - API reference
  - Deployment guide
  - Configuration guide
  - Architecture documentation
  - Protocol specification
  - Performance analysis
  - Real-time OS configuration guide

### Hardware Support
- ATSAM3X8E (Arduino Due)
- 16 digital I/O
- 8-channel 12-bit ADC
- 2-channel 12-bit DAC
- DMA-based ADC sampling

### Known Limitations
- Web interface lacks built-in authentication (use reverse proxy)
- Firmware protocol updates pending (documented in FIRMWARE_UPDATES.md)
- IPC only available on Linux/macOS

## [0.9.0] - Development versions

Development and testing versions. Not released.

---

## Versioning

Given a version number MAJOR.MINOR.PATCH:

1. MAJOR version for incompatible API changes
2. MINOR version for backwards-compatible functionality additions
3. PATCH version for backwards-compatible bug fixes

---

[Unreleased]: https://github.com/angleto/phycommander/compare/v2.0.0...HEAD
[2.0.0]: https://github.com/angleto/phycommander/releases/tag/v2.0.0
[1.1.0]: https://github.com/angleto/phycommander/releases/tag/v1.1.0
[1.0.0]: https://github.com/angleto/phycommander/releases/tag/v1.0.0
