angleto/phycommander/ATSAM3X8E_FW/ATSAM3X8E_FW/src/waveform.h

/*
 * SPDX-License-Identifier: GPL-3.0-or-later
 * SPDX-FileCopyrightText: 2014-2026 Angelo Leto <angelo@leto.blue>
 */
/**
 * \file
 *
 * \brief PhyCommander on-chip function generator — public types and API.
 *
 * Implements the per-channel control plane documented in
 * `docs/firmware/PROTOCOL.md` (vendor SETUP requests 0x10..0x21).
 *
 * Wire layout of every struct in this header is byte-identical with
 * the host-side definitions in
 * `physerver/crates/phycmd-core/src/protocol/wave_types.rs`.
 * Both sides assert sizes at compile time; if either side's struct
 * drifts, the build fails immediately and loudly.
 */

#ifndef _WAVEFORM_H_
#define _WAVEFORM_H_

#include <stdint.h>
#include <stdbool.h>
#include "compiler.h"   /* for COMPILER_PACK_SET / COMPILER_WORD_ALIGNED */

#ifdef __cplusplus
extern "C" {
#endif

/* -------------------------------------------------------------------------
 *   Vendor SETUP request opcodes (bRequest)
 *
 *   See PROTOCOL.md §2.1 for direction / wIndex / wValue conventions.
 * ------------------------------------------------------------------------- */
#define VREQ_GEN_GET_CAPS           0x10  /* IN  → Capabilities      */
#define VREQ_GEN_GET_STATE          0x11  /* IN  → ChannelState      */
#define VREQ_GEN_PLAY_BUILTIN       0x12  /* OUT ← WaveBuiltinSpec   */
#define VREQ_GEN_PLAY_ARBITRARY     0x13  /* OUT ← WaveArbHeader+pcm */
#define VREQ_GEN_STOP               0x14  /* OUT, no payload         */
#define VREQ_DAC_SET_CLOCK          0x18  /* OUT ← u32 clock_hz      */
#define VREQ_DAC_GET_CLOCK          0x19  /* IN  → u32 clock_hz      */
#define VREQ_ADC_SET_RATE           0x20  /* OUT ← u32 rate_hz       */
#define VREQ_ADC_GET_RATE           0x21  /* IN  → u32 rate_hz       */
/* Reactive (closed-loop) modes added in v2 — see PROTOCOL.md §3.2 */
#define VREQ_GEN_PLAY_LUT           0x30  /* OUT ← WaveLutSpec + entries  */
#define VREQ_GEN_PLAY_THRESHOLD     0x31  /* OUT ← WaveThresholdSpec      */
#define VREQ_GEN_PLAY_PULSE_TRIG    0x32  /* OUT ← WavePulseSpec          */
#define VREQ_GEN_PLAY_PID           0x38  /* OUT ← WavePidSpec  (v3)      */

/* Firmware-update path: clears GPNVM1 (= boot from ROM SAM-BA) and
 * issues a full hardware reset. After the reset the host sees the
 * SAM3X enumerate as 03eb:6124 (Atmel SAM-BA bootloader) on the
 * native USB port, and `bossac -e -w -v -b` can reflash without
 * relying on the 1200-baud / ATmega16U2 ERASE-pulse path. No DATA
 * stage; no reply (the chip resets mid-write, the host's outstanding
 * request is implicitly cancelled). */
#define VREQ_FW_ENTER_BOOTLOADER    0x40  /* OUT, no payload, no ack    */

/* -------------------------------------------------------------------------
 *   Wave shape selector (1 byte enum, transported as uint8_t)
 *
 *   SHAPE_OFF in ChannelState means the channel is back to MANUAL
 *   (the streaming Command frame drives it). Any other value means a
 *   generator is currently active.
 * ------------------------------------------------------------------------- */
typedef enum {
	/* Open-loop (output = f(time)) */
	SHAPE_OFF        = 0,
	SHAPE_DC         = 1,
	SHAPE_SINE       = 2,
	SHAPE_SQUARE     = 3,
	SHAPE_TRIANGLE   = 4,
	SHAPE_SAWTOOTH   = 5,
	SHAPE_ARBITRARY  = 6,
	/* Reactive (output = f(input)). 7..15 reserved for open-loop. */
	SHAPE_LUT        = 16,
	SHAPE_THRESHOLD  = 17,
	SHAPE_PULSE_TRIG = 18,
	SHAPE_PID        = 19,
} wave_shape_t;

/* Input source descriptor used by reactive modes (LUT/THRESHOLD/PID).
 * See PROTOCOL.md §2.3 for the full mapping. */
typedef enum {
	INPUT_SRC_NONE     = 0,
	INPUT_SRC_ADC      = 1,
	INPUT_SRC_DIN_MASK = 2,
} input_src_t;

/* Pulse edge selector for SHAPE_PULSE_TRIG. */
typedef enum {
	PULSE_EDGE_RISING  = 1,
	PULSE_EDGE_FALLING = 2,
	PULSE_EDGE_ANY     = 3,
} pulse_edge_t;

/* -------------------------------------------------------------------------
 *   Channel kind (1 byte enum)
 * ------------------------------------------------------------------------- */
typedef enum {
	CHAN_KIND_DAC  = 0,
	CHAN_KIND_PWM  = 1,
	CHAN_KIND_DOUT = 2,
	CHAN_KIND_DIN  = 3,
	CHAN_KIND_ADC  = 4,
} channel_kind_t;

/* -------------------------------------------------------------------------
 *   Mode bitmask used in Capabilities.modes_<kind>
 * ------------------------------------------------------------------------- */
#define MODE_MANUAL     (1u << 0)
#define MODE_BUILTIN    (1u << 1)
#define MODE_ARBITRARY  (1u << 2)
/* Reactive modes (added in v2). See PROTOCOL.md §3.2. */
#define MODE_LUT        (1u << 3)
#define MODE_THRESHOLD  (1u << 4)
#define MODE_PULSE_TRIG (1u << 5)
#define MODE_PID        (1u << 6)
/* bit 7 reserved for MODE_RULE_CHAIN. */

/* -------------------------------------------------------------------------
 *   ChannelState.flags bits (per-channel, returned by GEN_GET_STATE)
 *
 *   Currently only one flag is defined. The bits are mirrored in
 *   `wave_types.rs` on the host side so the dashboard can decode them
 *   without a version check.
 * ------------------------------------------------------------------------- */
#define CHAN_STATE_FLAG_RESERVED  (1u << 0)   /* channel ID exists but is
                                                 not backed by hardware on
                                                 this revision (e.g. PWM
                                                 4..7 on the Arduino Due —
                                                 no PIOC pins routed). */

/* -------------------------------------------------------------------------
 *   Channel inventory exposed by this firmware revision.
 *
 *   Flat channel ID space (used in wIndex of vendor SETUP requests):
 *     0..1   → DAC0..DAC1   (full waveform generator)
 *     2..9   → PWM0..PWM7   (MANUAL only in v1; four PWM peripheral
 *                            channels D9/D8/D7/D6 + four TC-backed
 *                            channels D10/D11/D5/D2)
 *     10..25 → DOUT0..DOUT15 (MANUAL only in v1)
 *     26..41 → DIN0..DIN15  (read-only)
 *     42..53 → ADC0..ADC11  (read-only; Due A0..A11)
 *
 *   The mapping is reported through GEN_GET_CAPS so the host doesn't
 *   need to hard-code it. Mirrors phycmd-core::protocol::wave_types
 *   exactly — bumping one side without the other breaks dispatch.
 *
 *   D3, D4 and D12 are NOT exposed as PWMs:
 *     D3  → front-panel reset button input
 *     D4  → reserved (would need TC2.ch0 paired with D5)
 *     D12 → reserved (would need TC2.ch2 paired with D11) */
#define WAVE_NUM_DAC          2u
#define WAVE_NUM_PWM          8u
#define WAVE_NUM_DOUT        16u
#define WAVE_NUM_DIN         16u
#define WAVE_NUM_ADC         12u
#define WAVE_NUM_CHANNELS    (WAVE_NUM_DAC + WAVE_NUM_PWM + WAVE_NUM_DOUT \
                              + WAVE_NUM_DIN + WAVE_NUM_ADC)   /* 54 */

/* DAC channel IDs (used in wIndex). Other kinds are derived by offset
 * if/when the firmware grows support for them (see PROTOCOL.md §2.4). */
#define WAVE_CHID_DAC0  0u
#define WAVE_CHID_DAC1  1u

/* Hardware limits exposed via Capabilities. */
#define WAVE_MAX_DAC_SAMPLE_RATE_HZ   1000000u   /* SAM3X DACC peak */
#define WAVE_MAX_ARB_SAMPLES          1024u      /* per-channel buffer */
/* Default DAC clock = 200 kSPS per channel (TC triggers at 400 kHz with
 * alternating channels). More than enough for audio-band signals with
 * generous oversampling (100 samples per 2 kHz cycle). Keeps the DACC
 * ENDTX ISR rate low enough that the 125-µs USB microframes never
 * get starved even during refill bursts.
 *
 * Users who need high-frequency signals (>~50 kHz fundamental) should
 * bump the DAC clock via DAC_SET_CLOCK up to the hardware limit
 * (WAVE_MAX_DAC_SAMPLE_RATE_HZ = 1 MSPS). Expect a small USB tick-rate
 * drop (~5-10%) at the top of that range — see PROTOCOL.md §4.4. */
#define WAVE_DEFAULT_DAC_CLOCK_HZ     200000u    /* 200 kSPS shared */

/* -------------------------------------------------------------------------
 *   Wire-format structs (single source of truth, mirrors PROTOCOL.md §6.1)
 *
 *   All fields naturally aligned, all little-endian, no implicit padding.
 *   Sizes verified by _Static_assert below.
 * ------------------------------------------------------------------------- */

COMPILER_PACK_SET(1)

struct Capabilities {
	uint8_t  protocol_version;       /* 0  : 1 in this revision      */
	uint8_t  reserved0;              /* 1  : must be 0               */
	uint16_t firmware_minor;         /* 2                            */
	uint16_t firmware_major;         /* 4                            */
	uint16_t reserved1;              /* 6                            */
	uint8_t  num_dac;                /* 8                            */
	uint8_t  num_pwm;                /* 9                            */
	uint8_t  num_dout;               /* 10                           */
	uint8_t  num_din;                /* 11                           */
	uint8_t  num_adc;                /* 12                           */
	uint8_t  reserved2[3];           /* 13..15                       */
	uint8_t  modes_dac;              /* 16 : bitmask MODE_*          */
	uint8_t  modes_pwm;              /* 17                           */
	uint8_t  modes_dout;             /* 18                           */
	uint8_t  modes_din;              /* 19                           */
	uint8_t  modes_adc;              /* 20                           */
	uint8_t  reserved3[3];           /* 21..23                       */
	uint32_t max_dac_sample_rate_hz; /* 24                           */
	uint32_t max_arb_buffer_samples; /* 28                           */
};                                    /* total 32 bytes              */

struct WaveBuiltinSpec {
	uint8_t  shape;                  /* 0  : wave_shape_t            */
	uint8_t  flags;                  /* 1  : reserved (must be 0)    */
	uint16_t duty_x10;               /* 2  : 0..1000 = 0..100%       */
	uint16_t amplitude;              /* 4  : peak-to-peak            */
	uint16_t offset;                 /* 6  : mid-point               */
	uint32_t freq_mHz;               /* 8  : signal frequency, mHz   */
	uint16_t phase_offset_x16;       /* 12 : reserved (must be 0)    */
	uint16_t reserved1;              /* 14 : must be 0               */
};                                    /* total 16 bytes              */

struct WaveArbHeader {
	uint16_t n_samples;              /* 0  : 1..max_arb_buffer_samples */
	uint16_t loop_count;             /* 2  : 0 = infinite              */
	uint32_t sample_rate_hz;         /* 4  : playback rate             */
	/* int16_t samples[n_samples] follows */
};                                    /* total 8 bytes (header only)  */

/* Reactive-mode payloads (v2). See PROTOCOL.md §2.3 for full docs. */

struct WaveLutSpec {
	uint8_t  input_src;              /* 0  : input_src_t              */
	uint8_t  reserved0;              /* 1  : must be 0                */
	uint16_t input_arg;              /* 2  : ADC ch (low 3) or DIN bitmask */
	uint16_t n_entries;              /* 4  : 1..4096                  */
	uint16_t output_mask;            /* 6  : DOUT bits (DAC: ignored) */
	uint32_t reserved1;              /* 8  : must be 0                */
	/* int16_t entries[n_entries] follows */
};                                    /* total 12 bytes (header only) */

struct WaveThresholdSpec {
	uint8_t  input_src;              /* 0                              */
	uint8_t  reserved0;              /* 1  : must be 0                */
	uint16_t input_arg;              /* 2                              */
	uint16_t thr_high;               /* 4                              */
	uint16_t thr_low;                /* 6                              */
	uint16_t val_high;               /* 8                              */
	uint16_t val_low;                /* 10                             */
	uint32_t reserved1;              /* 12 : must be 0                */
};                                    /* total 16 bytes              */

struct WavePulseSpec {
	uint8_t  input_din_bit;          /* 0  : 0..15                    */
	uint8_t  edge;                   /* 1  : pulse_edge_t             */
	uint8_t  active_level;           /* 2  : 0 or 1                   */
	uint8_t  reserved0;              /* 3  : must be 0                */
	uint32_t duration_us;            /* 4  : 1..1_000_000             */
	uint32_t cooldown_us;            /* 8  : 0..1_000_000             */
};                                    /* total 12 bytes              */

struct WavePidSpec {                  /* (v3) reserved slot          */
	uint8_t  input_src;              /* 0                              */
	uint8_t  reserved0;
	uint16_t input_arg;
	uint32_t sample_rate_hz;
	int32_t  setpoint;
	int32_t  kp_q16_16;
	int32_t  ki_q16_16;
	int32_t  kd_q16_16;
	uint16_t out_min;
	uint16_t out_max;
	int32_t  integral_clamp;
};                                    /* total 32 bytes              */

struct ChannelState {
	uint8_t  channel_kind;           /* 0  : channel_kind_t          */
	uint8_t  channel_index;          /* 1                            */
	uint8_t  shape;                  /* 2  : SHAPE_OFF = MANUAL      */
	uint8_t  flags;                  /* 3                            */
	uint32_t freq_mHz;               /* 4                            */
	uint16_t duty_x10;               /* 8                            */
	uint16_t amplitude;              /* 10                           */
	uint16_t offset;                 /* 12                           */
	uint16_t phase_offset_x16;       /* 14                           */
	uint16_t arb_n_samples;          /* 16                           */
	uint16_t arb_loops_remaining;    /* 18                           */
	uint32_t arb_sample_rate_hz;     /* 20                           */
	uint32_t cur_phase_q24_8;        /* 24                           */
	uint32_t reserved;               /* 28                           */
};                                    /* total 32 bytes              */

COMPILER_PACK_RESET()

/* Build-time guards. If any of these fire, do NOT widen the struct
 * with extra padding — fix the field alignment so the wire layout
 * matches the doc, then tell the host to do the same. */
_Static_assert(sizeof(struct Capabilities)      == 32, "Capabilities wire size");
_Static_assert(sizeof(struct WaveBuiltinSpec)   == 16, "WaveBuiltinSpec wire size");
_Static_assert(sizeof(struct WaveArbHeader)     ==  8, "WaveArbHeader wire size");
_Static_assert(sizeof(struct WaveLutSpec)       == 12, "WaveLutSpec wire size");
_Static_assert(sizeof(struct WaveThresholdSpec) == 16, "WaveThresholdSpec wire size");
_Static_assert(sizeof(struct WavePulseSpec)     == 12, "WavePulseSpec wire size");
_Static_assert(sizeof(struct WavePidSpec)       == 32, "WavePidSpec wire size");
_Static_assert(sizeof(struct ChannelState)      == 32, "ChannelState wire size");

/* -------------------------------------------------------------------------
 *   Public API (called from main / udi_vendor)
 * ------------------------------------------------------------------------- */

/**
 * \brief Initialise the function generator subsystem.
 *
 * Must be called once after `dac_setup()` and before `udc_start()`.
 * Configures TC0 channel 0 as the shared DAC sample clock at
 * WAVE_DEFAULT_DAC_CLOCK_HZ, allocates the ping-pong buffers in
 * SRAM, and parks all channels in SHAPE_OFF (MANUAL, default).
 */
void waveform_init(void);

/**
 * \brief Stop every running generator and return all channels to
 * SHAPE_OFF. Called from `udi_vendor_disable()` for safety so that
 * a host disconnect can never leave a DAC oscillating in the wild.
 */
void waveform_stop_all(void);

/**
 * \brief Returns true iff DAC channel `dac_idx` (0 or 1) is currently
 * generator-driven (i.e. its shape != SHAPE_OFF). The streaming
 * `apply_command_frame()` calls this to decide whether to write the
 * Command frame's dacN field to the DAC peripheral.
 */
bool waveform_dac_is_generating(uint8_t dac_idx);

/**
 * \brief Update the per-channel MANUAL hold value used by the PDC
 * refill loop when the channel is in SHAPE_OFF (and the PDC is still
 * running because the OTHER channel is generating). Called from
 * `apply_command_frame` after a successful DAC write, so the
 * transition GENERATOR → MANUAL never snaps the DAC to mid-rail.
 *
 * No-op if `dac_idx >= WAVE_NUM_DAC`.
 */
void waveform_set_manual_hold(uint8_t dac_idx, uint16_t v12);

/**
 * \brief Returns true iff PWM channel `pwm_idx` (0..3) is currently
 * generator-driven (a `play_builtin` / `play_pid` etc. is active on
 * it). `apply_command_frame()` uses this to decide whether the
 * streaming cmd.pwmN duty should reach the hardware: if the channel
 * is in generator mode, writing a manual duty here would glitch the
 * running waveform.
 *
 * Returns false for `pwm_idx >= WAVE_NUM_PWM_ACTIVE`.
 */
bool waveform_pwm_is_generating(uint8_t pwm_idx);

/**
 * \brief Apply a manual duty cycle on PWM channel `pwm_idx`. Duty is
 * a u16 in [0, 65535] where 0 = always-low and 65535 = always-high.
 * Uses a fixed 1 kHz carrier (chosen as a sensible default for
 * manual slider control); scripts that need a different carrier
 * should use the fngen `play_builtin` path with shape = square
 * instead.
 *
 * The channel is started on the first call after boot (or after a
 * fngen stop) and then updated live on subsequent calls via the
 * PWM peripheral's UPD registers — the change lands at the next
 * period boundary without glitching the output.
 *
 * No-op if `pwm_idx >= WAVE_NUM_PWM_ACTIVE` or if the channel is
 * currently in generator mode.
 */
void waveform_set_pwm_manual(uint8_t pwm_idx, uint16_t duty_u16);

/**
 * \brief Stop the manual PWM on channel `pwm_idx`: parks the pin
 * low. Called when the streaming duty returns to zero AND the
 * channel is no longer generator-driven. Also called indirectly
 * when fngen takes over via `play_builtin`.
 */
void waveform_stop_pwm_manual(uint8_t pwm_idx);

/* -------------------------------------------------------------------------
 *   Vendor SETUP entrypoints (called from udi_vendor_setup)
 *
 *   Each one returns true on success (the UDC will ACK the control
 *   transfer) or false on validation failure (the UDC will STALL).
 *
 *   `data` and `len` describe the SETUP payload (DATA stage) when
 *   present; pass NULL/0 for requests with no payload.
 * ------------------------------------------------------------------------- */

/**
 * \brief Fill `out` with the current Capabilities of this firmware.
 * Returns true if `out_len >= sizeof(Capabilities)`.
 */
bool waveform_get_caps(void *out, uint16_t out_len);

/**
 * \brief Fill `out` with the live ChannelState for the given flat
 * channel ID. STALLs if `channel_id >= WAVE_NUM_CHANNELS` or the
 * out buffer is too small.
 */
bool waveform_get_state(uint16_t channel_id, void *out, uint16_t out_len);

/**
 * \brief Start (or seamlessly update) a built-in waveform on a DAC
 * channel. Validates the spec per PROTOCOL.md §2.5. Returns true on
 * success.
 */
bool waveform_play_builtin(uint16_t channel_id, const void *data, uint16_t len);

/**
 * \brief Start (or replace) playback of an arbitrary waveform on a
 * DAC channel. The DATA payload is `WaveArbHeader` followed by
 * `n_samples * sizeof(int16_t)` bytes.
 */
bool waveform_play_arbitrary(uint16_t channel_id, const void *data, uint16_t len);

/**
 * \brief Stop the generator on the channel and revert to SHAPE_OFF.
 * Idempotent: stopping an already-stopped channel succeeds silently.
 */
bool waveform_stop(uint16_t channel_id);

/**
 * \brief Switch a channel into reactive LUT mode. Output =
 * LUT[input_quantized]. Validates spec and entry payload size.
 */
bool waveform_play_lut(uint16_t channel_id, const void *data, uint16_t len);

/**
 * \brief Switch a channel into reactive THRESHOLD mode (analog
 * comparator with hysteresis).
 */
bool waveform_play_threshold(uint16_t channel_id, const void *data, uint16_t len);

/**
 * \brief Switch a channel into reactive PULSE_TRIG mode (DIN edge →
 * timed monostable).
 */
bool waveform_play_pulse_trig(uint16_t channel_id, const void *data, uint16_t len);

/**
 * \brief Switch a channel into reactive PID mode (closed-loop). [v3]
 */
bool waveform_play_pid(uint16_t channel_id, const void *data, uint16_t len);

/* -------------------------------------------------------------------------
 *   Hooks called from main.c
 * ------------------------------------------------------------------------- */

/** Called every 1 ms from SysTick_Handler — services pulse cooldowns. */
void waveform_systick_1ms(void);

/** Called from main()'s polled DIN loop whenever digital_in changes. */
void waveform_on_din_change(uint16_t new_din, uint16_t prev_din);

/** Bitmask of DOUT channels currently owned by a reactive generator
 * (LUT, THRESHOLD, PULSE_TRIG). Bits set here must NOT be overwritten
 * by the iso Command-frame digital_out path, otherwise the manual
 * stream races against the generator at microframe rate. */
uint16_t waveform_reactive_dout_mask(void);

/**
 * \brief Set / get the shared DAC sample clock in Hz. Range
 * 1..WAVE_MAX_DAC_SAMPLE_RATE_HZ. Both DAC channels share this clock.
 */
bool waveform_set_dac_clock(uint32_t clock_hz);
uint32_t waveform_get_dac_clock(void);

/**
 * \brief Set / get the ADC sampling rate in Hz. Independent of the
 * DAC clock; range 1..WAVE_MAX_DAC_SAMPLE_RATE_HZ.
 */
bool waveform_set_adc_rate(uint32_t rate_hz);
uint32_t waveform_get_adc_rate(void);

#ifdef __cplusplus
}
#endif

#endif /* _WAVEFORM_H_ */
