angleto/phycommander/physerver/crates/phycmd-core/src/scheduler.rs

// SPDX-License-Identifier: AGPL-3.0-or-later
// SPDX-FileCopyrightText: 2026 Angelo Leto <angelo@leto.blue>

//! Hard-paced real-time scheduler.
//!
//! This is the loop that turns staging writes into actual USB
//! traffic at a deterministic tick rate. It ties together the
//! other modules in this crate:
//!
//!   * [`crate::staging::CommandStaging`] — composes the next frame
//!   * [`crate::transport::Transport`]    — sends it on the wire
//!   * [`crate::status_bus::StatusBus`]   — broadcasts the response
//!   * [`crate::stats::RtStats`]          — counts everything
//!   * [`crate::rt_setup`]                — SCHED_FIFO / mlockall / affinity
//!
//! ## Timing discipline
//!
//! The scheduler uses `clock_nanosleep(CLOCK_MONOTONIC, TIMER_ABSTIME)`
//! with an absolute target timestamp that is advanced by exactly
//! `period_ns` each iteration, *independently* of how long the
//! previous iteration took. This is the canonical pattern for
//! hard-RT loops on Linux: it eliminates the drift that a naive
//! `sleep(period)` after the I/O would accumulate, and lets jitter
//! be accounted for explicitly.
//!
//! If a tick overruns its deadline (e.g. the transport took longer
//! than the period), the scheduler *does not* immediately fire the
//! next tick to "catch up". Instead it computes how many periods
//! have already elapsed, logs that as `missed_ticks`, and schedules
//! the next tick at the earliest future boundary. This preserves
//! the phase of the loop — subsequent ticks still fall on the
//! original grid — and surfaces slippage as an explicit metric
//! rather than silently corrupting timing.

use std::sync::{
    atomic::{AtomicBool, Ordering},
    Arc,
};

use anyhow::Result;
use tracing::{error, info, trace, warn};

use crate::{
    config::RtConfig,
    staging::CommandStaging,
    stats::RtStats,
    status_bus::{StatusBus, StatusFrame},
    transport::{PipelinedTransport, Transport},
};

// -------------------------------------------------------------------------
//   Stop handle
// -------------------------------------------------------------------------

/// Shared stop flag. Cloneable. Calling [`RtSchedulerStopHandle::stop`]
/// asks the scheduler loop to exit at the top of the next tick.
#[derive(Clone, Debug)]
pub struct RtSchedulerStopHandle {
    flag: Arc<AtomicBool>,
}

impl RtSchedulerStopHandle {
    /// Signal the scheduler to stop. Safe to call from any thread.
    pub fn stop(&self) {
        self.flag.store(true, Ordering::Release);
    }

    pub fn is_stopping(&self) -> bool {
        self.flag.load(Ordering::Acquire)
    }
}

// -------------------------------------------------------------------------
//   RtScheduler
// -------------------------------------------------------------------------

pub struct RtScheduler {
    config: RtConfig,
    staging: Arc<CommandStaging>,
    bus: Arc<StatusBus>,
    stats: Arc<RtStats>,
    transport_sync: Option<Box<dyn Transport>>,
    transport_pipe: Option<Box<dyn PipelinedTransport>>,
    stop: Arc<AtomicBool>,
}

impl RtScheduler {
    /// Construct a scheduler with a synchronous transport
    /// (write+read blocking per tick).
    pub fn new(
        config: RtConfig,
        staging: Arc<CommandStaging>,
        bus: Arc<StatusBus>,
        stats: Arc<RtStats>,
        transport: Box<dyn Transport>,
    ) -> Self {
        Self {
            config,
            staging,
            bus,
            stats,
            transport_sync: Some(transport),
            transport_pipe: None,
            stop: Arc::new(AtomicBool::new(false)),
        }
    }

    /// Construct a scheduler with a pipelined transport
    /// (submit/reap overlapped with sleep).
    pub fn new_pipelined(
        config: RtConfig,
        staging: Arc<CommandStaging>,
        bus: Arc<StatusBus>,
        stats: Arc<RtStats>,
        transport: Box<dyn PipelinedTransport>,
    ) -> Self {
        Self {
            config,
            staging,
            bus,
            stats,
            transport_sync: None,
            transport_pipe: Some(transport),
            stop: Arc::new(AtomicBool::new(false)),
        }
    }

    /// Return a handle that can be used to request loop termination
    /// from another thread.
    pub fn stop_handle(&self) -> RtSchedulerStopHandle {
        RtSchedulerStopHandle { flag: Arc::clone(&self.stop) }
    }

    /// Run the scheduler loop on the *current* thread until
    /// [`RtSchedulerStopHandle::stop`] is called from somewhere.
    ///
    /// If `config.enable_rt` is true, RT optimisations are applied
    /// (SCHED_FIFO priority, memory locking, CPU affinity, DMA
    /// latency) **on this thread** before entering the loop. A
    /// typical deployment spawns a dedicated `std::thread::Builder`
    /// and calls this inside the closure; the HTTP server, WebSocket
    /// endpoints, IPC shared memory, etc. all live on other threads
    /// with normal scheduling policy.
    /// Run the scheduler loop on the *current* thread until
    /// [`RtSchedulerStopHandle::stop`] is called.
    ///
    /// Dispatches to the sync or pipelined inner loop based on the
    /// transport provided at construction time. RT optimisations are
    /// applied once at the top of `run`, regardless of mode.
    pub fn run(mut self) -> Result<()> {
        self.config.validate()?;

        if self.config.is_aggressive_rate() {
            warn!(
                "rate_hz={} is above the measured safe ceiling (~15 kHz) on EHCI + SAM3X \
                 hardware; missed ticks are likely",
                self.config.rate_hz
            );
        }

        if self.config.enable_rt {
            let rt_cfg = crate::rt_setup::RtConfig {
                enable_rt_scheduler: true,
                rt_priority: self.config.rt_priority,
                lock_memory: self.config.lock_memory,
                set_cpu_affinity: self.config.cpu_affinity.is_some(),
                cpu_core: self.config.cpu_affinity,
                set_dma_latency: self.config.dma_latency_us.is_some(),
            };
            if let Err(e) = crate::rt_setup::apply_rt_optimizations(&rt_cfg) {
                warn!("failed to apply some RT optimisations: {}", e);
            }
        }

        if let Some(mut t) = self.transport_sync.take() {
            self.run_sync(t.as_mut())
        } else if let Some(mut t) = self.transport_pipe.take() {
            self.run_pipelined(t.as_mut())
        } else {
            anyhow::bail!("no transport configured")
        }
    }

    // =================================================================
    //   Synchronous loop (original — one blocking exchange per tick)
    // =================================================================

    fn run_sync(&self, transport: &mut dyn Transport) -> Result<()> {
        let period_ns = self.config.tick_period().as_nanos() as i64;
        let start_ns = now_monotonic_ns();
        info!(
            "RtScheduler running (sync): rate={} Hz, period={} ns",
            self.config.rate_hz, period_ns
        );

        let mut tick_index: u64 = 0;
        let mut cmd_seq: u64 = 0;

        loop {
            if self.stop.load(Ordering::Acquire) {
                info!("RtScheduler stop: {} ticks", tick_index);
                return Ok(());
            }

            let tick_expected_ns = start_ns + (tick_index as i64) * period_ns;
            if let Err(e) = sleep_until_abs_monotonic(tick_expected_ns) {
                error!("clock_nanosleep: {e}");
                return Err(e.into());
            }

            let tick_sent_ns = now_monotonic_ns();
            let jitter_ns = tick_sent_ns - tick_expected_ns;
            let jitter_us = clamp_to_i32(jitter_ns / 1_000);

            let missed_prior = if jitter_ns > period_ns {
                let n = (jitter_ns / period_ns) as u64;
                self.stats.record_missed(n as u32);
                n as u32
            } else {
                0
            };
            tick_index = tick_index + 1 + missed_prior as u64;

            let (mut cmd, write_gen) = self.staging.take_snapshot();
            cmd.seq_num = (cmd_seq & 0xFF) as u8;

            let io_result = transport.exchange(&cmd);
            self.staging.mark_sent(write_gen);
            let tick_recv_ns = now_monotonic_ns();

            match io_result {
                Ok(status) => {
                    let latency_us = clamp_to_u32((tick_recv_ns - tick_sent_ns) / 1_000);
                    self.stats.record_ok(latency_us, jitter_us);
                    let wire_seq = status.seq_num;
                    self.bus.publish(StatusFrame {
                        status,
                        cmd_seq,
                        wire_seq,
                        tick_index,
                        tick_expected_ns,
                        tick_sent_ns,
                        tick_recv_ns,
                        latency_us,
                        jitter_us,
                        missed_ticks_prior: missed_prior,
                    });
                }
                Err(e) => {
                    trace!("sync exchange failed: {e}");
                    self.stats.record_transport_error();
                    self.stats.record_missed(1);
                }
            }

            cmd_seq = cmd_seq.wrapping_add(1);
        }
    }

    // =================================================================
    //   Pipelined loop — submit/sleep/reap overlapped
    //
    //   Timeline for a single tick:
    //
    //     tick N wakeup
    //       ├─ REAP response from tick N-1     (~5 μs channel recv)
    //       ├─ mark_sent(N-1) + publish(N-1)
    //       ├─ SNAPSHOT staging for tick N
    //       ├─ SUBMIT command N                 (~5 μs channel send)
    //       └─ SLEEP until tick N+1 deadline
    //              └── I/O helper thread does write_bulk+read_bulk ──┘
    //
    //   The USB round-trip happens DURING the sleep. The scheduler
    //   thread CPU footprint per tick is ~10-15 μs instead of ~350.
    // =================================================================

    fn run_pipelined(&self, transport: &mut dyn PipelinedTransport) -> Result<()> {
        let period_ns = self.config.tick_period().as_nanos() as i64;
        let start_ns = now_monotonic_ns();
        info!(
            "RtScheduler running (pipelined): rate={} Hz, period={} ns",
            self.config.rate_hz, period_ns
        );

        let mut tick_index: u64 = 0;
        let mut cmd_seq: u64 = 0;

        // State for the 1-tick-behind reap pattern. `None` means
        // no transfer is in flight (true at the very first tick and
        // after a submit failure).
        struct InFlight {
            write_gen: u64,
            tick_submitted_ns: i64,
            tick_expected_ns: i64,
            cmd_seq: u64,
            tick_index: u64,
            missed_prior: u32,
            jitter_us: i32,
        }
        let mut in_flight: Option<InFlight> = None;

        loop {
            if self.stop.load(Ordering::Acquire) {
                // Drain last in-flight transfer so mark_sent fires
                // and BlockUntilSent waiters unblock.
                if in_flight.is_some() {
                    match transport.drain(self.config.transport_timeout) {
                        Ok(Some(status)) => {
                            let ifr = in_flight.take().unwrap();
                            self.staging.mark_sent(ifr.write_gen);
                            let tick_recv_ns = now_monotonic_ns();
                            let latency_us =
                                clamp_to_u32((tick_recv_ns - ifr.tick_submitted_ns) / 1_000);
                            self.stats.record_ok(latency_us, ifr.jitter_us);
                            let wire_seq = status.seq_num;
                            self.bus.publish(StatusFrame {
                                status,
                                cmd_seq: ifr.cmd_seq,
                                wire_seq,
                                tick_index: ifr.tick_index,
                                tick_expected_ns: ifr.tick_expected_ns,
                                tick_sent_ns: ifr.tick_submitted_ns,
                                tick_recv_ns,
                                latency_us,
                                jitter_us: ifr.jitter_us,
                                missed_ticks_prior: ifr.missed_prior,
                            });
                        }
                        _ => {
                            let ifr = in_flight.take().unwrap();
                            self.staging.mark_sent(ifr.write_gen);
                        }
                    }
                }
                info!("RtScheduler stop (pipelined): {} ticks", tick_index);
                return Ok(());
            }

            // -- sleep until the tick deadline ---------------------
            let tick_expected_ns = start_ns + (tick_index as i64) * period_ns;
            if let Err(e) = sleep_until_abs_monotonic(tick_expected_ns) {
                error!("clock_nanosleep: {e}");
                return Err(e.into());
            }

            let tick_wakeup_ns = now_monotonic_ns();
            let jitter_ns = tick_wakeup_ns - tick_expected_ns;
            let jitter_us = clamp_to_i32(jitter_ns / 1_000);

            // catch-up
            let missed_prior = if jitter_ns > period_ns {
                let n = (jitter_ns / period_ns) as u64;
                self.stats.record_missed(n as u32);
                n as u32
            } else {
                0
            };
            tick_index = tick_index + 1 + missed_prior as u64;

            // -- REAP the previous tick's response (if any) -------
            if let Some(ifr) = in_flight.take() {
                match transport.reap(self.config.transport_timeout) {
                    Ok(status) => {
                        let tick_recv_ns = now_monotonic_ns();
                        self.staging.mark_sent(ifr.write_gen);
                        let latency_us =
                            clamp_to_u32((tick_recv_ns - ifr.tick_submitted_ns) / 1_000);
                        self.stats.record_ok(latency_us, ifr.jitter_us);
                        let wire_seq = status.seq_num;
                        self.bus.publish(StatusFrame {
                            status,
                            cmd_seq: ifr.cmd_seq,
                            wire_seq,
                            tick_index: ifr.tick_index,
                            tick_expected_ns: ifr.tick_expected_ns,
                            tick_sent_ns: ifr.tick_submitted_ns,
                            tick_recv_ns,
                            latency_us,
                            jitter_us: ifr.jitter_us,
                            missed_ticks_prior: ifr.missed_prior,
                        });
                    }
                    Err(e) => {
                        trace!("reap failed: {e}");
                        self.staging.mark_sent(ifr.write_gen);
                        self.stats.record_transport_error();
                        self.stats.record_missed(1);
                    }
                }
            }

            // -- SNAPSHOT + SUBMIT for this tick ------------------
            let (mut cmd, write_gen) = self.staging.take_snapshot();
            cmd.seq_num = (cmd_seq & 0xFF) as u8;

            match transport.submit(&cmd) {
                Ok(()) => {
                    in_flight = Some(InFlight {
                        write_gen,
                        tick_submitted_ns: now_monotonic_ns(),
                        tick_expected_ns,
                        cmd_seq,
                        tick_index,
                        missed_prior,
                        jitter_us,
                    });
                }
                Err(e) => {
                    error!("submit failed: {e}");
                    self.staging.mark_sent(write_gen);
                    self.stats.record_transport_error();
                    // in_flight stays None — next tick will skip reap
                }
            }

            cmd_seq = cmd_seq.wrapping_add(1);
        }
    }
}

// -------------------------------------------------------------------------
//   libc wall-clock helpers
// -------------------------------------------------------------------------

#[inline]
fn now_monotonic_ns() -> i64 {
    let mut ts = libc::timespec { tv_sec: 0, tv_nsec: 0 };
    // SAFETY: `clock_gettime(CLOCK_MONOTONIC, ...)` is always safe
    // with a valid `timespec` pointer.
    unsafe {
        libc::clock_gettime(libc::CLOCK_MONOTONIC, &mut ts);
    }
    ts.tv_sec as i64 * 1_000_000_000 + ts.tv_nsec as i64
}

/// `clock_nanosleep(CLOCK_MONOTONIC, TIMER_ABSTIME, target_ns)`.
///
/// Sleeps until the absolute monotonic timestamp `target_ns`. If
/// the timestamp is in the past, returns immediately. Returns an
/// `io::Error` with the POSIX errno on any other failure.
#[cfg(target_os = "linux")]
fn sleep_until_abs_monotonic(target_ns: i64) -> std::io::Result<()> {
    let ts =
        libc::timespec { tv_sec: target_ns / 1_000_000_000, tv_nsec: target_ns % 1_000_000_000 };
    // SAFETY: `&ts` is a valid pointer to an initialised `timespec`.
    // clock_nanosleep is a thread-safe libc call.
    let rc = unsafe {
        libc::clock_nanosleep(libc::CLOCK_MONOTONIC, libc::TIMER_ABSTIME, &ts, std::ptr::null_mut())
    };
    if rc == 0 {
        Ok(())
    } else {
        // clock_nanosleep returns the errno directly; it does NOT
        // set the global errno.
        Err(std::io::Error::from_raw_os_error(rc))
    }
}

/// Non-Linux fallback for the test suite running on developer
/// machines (macOS does not have `clock_nanosleep` in libc prior to
/// 10.12 and its semantics around `TIMER_ABSTIME` are quirky).
///
/// Busy-spins on `clock_gettime` which is correct for short sleeps
/// but wasteful; since production is Linux-only, this only exists
/// to let `cargo test` run locally.
#[cfg(not(target_os = "linux"))]
fn sleep_until_abs_monotonic(target_ns: i64) -> std::io::Result<()> {
    loop {
        let now = now_monotonic_ns();
        if now >= target_ns {
            return Ok(());
        }
        let delta = target_ns - now;
        if delta > 1_000_000 {
            // More than 1 ms to go: coarse sleep for delta - 500 μs
            std::thread::sleep(std::time::Duration::from_nanos((delta - 500_000) as u64));
        } else {
            // Final approach: yield to the scheduler to keep from
            // pinning the core at 100% in debug mode.
            std::thread::yield_now();
        }
    }
}

#[inline]
fn clamp_to_u32(v: i64) -> u32 {
    if v < 0 {
        0
    } else if v > u32::MAX as i64 {
        u32::MAX
    } else {
        v as u32
    }
}

#[inline]
fn clamp_to_i32(v: i64) -> i32 {
    if v < i32::MIN as i64 {
        i32::MIN
    } else if v > i32::MAX as i64 {
        i32::MAX
    } else {
        v as i32
    }
}

// =========================================================================
//   Tests
// =========================================================================
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
