angleto/phycommander/physerver/crates/phycmd-core/src/stats.rs

//! Runtime statistics for the RT scheduler.
//!
//! The scheduler updates a [`RtStats`] struct after each tick with
//! latency, jitter, and missed-tick accounting. The stats are
//! designed to be cheap to update on the hot path (atomic increments
//! + a bucketed histogram with a few integer ops) and cheap to
//! snapshot for `/api/stats` or logs.
//!
//! All fields are `AtomicU64` / `AtomicI64` so readers can observe
//! a consistent snapshot without taking a lock. Cross-field
//! consistency is *not* guaranteed (a concurrent snapshot may see
//! `tick_count = N` and `missed_ticks = M+1`), which is fine for
//! diagnostics and aggregated metrics.

use std::sync::atomic::{AtomicI64, AtomicU32, AtomicU64, Ordering};

// -------------------------------------------------------------------------
//   Jitter histogram
// -------------------------------------------------------------------------
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
