angleto/phycommander/(notices)

Notices in the files:
README.md:
https://img.shields.io/badge/software-AGPL--3.0%20%2F%20GPL--3.0-blue
